Alireza-Sotoodeh/DeadReckoner/Report/Progress.md

## Software Architecture Evolution & Development Phases (ESP32-S3 N16R8)

The development of DeadReckoner followed a staged architecture-driven roadmap. Each phase established the technical foundation required for subsequent phases. The progression reflects the actual implementation history of the project, from early sensor evaluation to the current multi-core data-logging platform.

---

#### Phase 0: Legacy Prototype & Sensor Research [COMPLETED]

This phase focused on evaluating inertial navigation hardware and establishing the initial software baseline.

- [x] **Project Bootstrap:** Create the initial firmware framework and repository structure.
- [x] **MPU6500 Evaluation:** Integrate and validate the MPU6500 sensor library.
- [x] **DMP Integration:** Add and evaluate Digital Motion Processor (DMP) support.
- [x] **STM32/CubeIDE Development Environment:** Establish the initial embedded development workflow.
- [x] **Sensor Communication Validation:** Verify low-level IMU communication and register access.
- [x] **Linear Acceleration Processing:** Correct gravity-compensated acceleration calculations.
- [x] **OLED Interface Experiments:** Develop and validate the first display subsystem.
- [x] **Prototype Validation:** Confirm basic IMU acquisition and display functionality.

---

#### Phase 1: ESP32-S3 Migration & System Architecture [COMPLETED]

The project architecture was redesigned around the ESP32-S3 platform to provide additional processing power, memory resources, and real-time scheduling capabilities.

- [x] **Platform Migration:** Migrate the firmware from the ESP8266 NodeMCU platform to the ESP32-S3 N16R8.
- [x] **Firmware Reinitialization:** Rebuild the project structure around the new hardware platform.
- [x] **Pin Porting:** Remap all peripherals to the ESP32-S3 IO matrix.
- [x] **Hardware Redesign:** Update wiring architecture and peripheral connections.
- [x] **Firmware Flash Configuration:** Configure flashing and deployment parameters for ESP32-S3.
- [x] **System Bring-Up Verification:** Validate successful operation of all onboard peripherals.

---

#### Phase 2: RTOS & Multi-Core Framework [COMPLETED]

This phase transformed the firmware from a monolithic design into a real-time multi-core architecture.

- [x] **FreeRTOS Integration:** Introduce task-based scheduling.
- [x] **Dual-Core Architecture:** Separate acquisition and storage workloads across CPU cores.
- [x] **Sensor Task Implementation:** Execute high-frequency sensor acquisition on Core 0.
- [x] **Logging Task Implementation:** Execute storage operations on Core 1.
- [x] **Producer–Consumer Model:** Establish queue-based communication between tasks.
- [x] **Thread-Safe Data Exchange:** Replace shared-state communication with message passing.
- [x] **Race Condition Mitigation:** Eliminate direct inter-task memory contention.
- [x] **Real-Time Stability Validation:** Verify deterministic operation under sustained load.

---

#### Phase 3: Calibration & I2C Optimization [COMPLETED]

This phase focused on improving sensor accuracy, calibration persistence, and I2C bus reliability.

- [x] **I2C Fast Mode:** Increase bus speed to 400 kHz.
- [x] **EEPROM Calibration Storage:** Implement persistent storage for calibration data.
- [x] **Calibration Restoration:** Automatically restore bias values during startup.
- [x] **Calibration Compensation Fix:** Correct post-load sensor offset behavior.
- [x] **Bus Collision Prevention:** Suspend acquisition during EEPROM write operations.
- [x] **Dual-I2C Topology:** Move OLED traffic to the secondary I2C controller (`Wire1`).
- [x] **I2C Stability Validation:** Verify reliable operation of all I2C peripherals.

---

#### Phase 4: Hardware Validation & Performance Testing [COMPLETED]

This phase established confidence in hardware reliability and sensor performance through structured testing.

- [x] **MPU9250 Sanity Check:** Validate IMU initialization and communication.
- [x] **OLED Sanity Check:** Validate display communication and rendering.
- [x] **Hardware Integration Testing:** Verify complete system functionality.
- [x] **Static Drift Evaluation:** Measure long-term orientation stability.
- [x] **Dynamic Return-to-Zero Testing:** Evaluate accumulated drift after motion.
- [x] **Vibration Rejection Testing:** Assess filter robustness under vibration.
- [x] **Filter Validation:** Verify orientation estimation consistency.
- [x] **Performance Visualization Tools:** Develop drift-analysis visualization utilities.

---

#### Phase 5: SD Card Storage Architecture [COMPLETED]

This phase focused on selecting and validating a reliable storage subsystem for mission logging.

- [x] **SD Card Interface Investigation:** Evaluate multiple SD card connection strategies.
- [x] **SPI Storage Architecture:** Adopt SPI-based storage communication.
- [x] **Standalone SD Validation:** Create isolated SD card validation firmware.
- [x] **Hardware Adapter Evaluation:** Compare SD adapter implementations.
- [x] **Signal Integrity Optimization:** Operate entirely on the 3.3 V logic domain.
- [x] **SPI Frequency Optimization:** Limit SPI frequency to 10 MHz for stable operation.
- [x] **Storage Benchmarking:** Evaluate practical write performance.
- [x] **Final Storage Validation:** Successfully validate long-duration SD card operation.

---

#### Phase 6: Binary Logging Framework [COMPLETED]

The storage subsystem was expanded into a structured binary data-logging architecture.

- [x] **LogFrame Definition:** Design a fixed-size binary telemetry structure.

- [x] **Timestamp Integration:** Store acquisition timestamps for every sample.

- [x] **Quaternion Logging:** Record fused orientation estimates.

- [x] **Linear Acceleration Logging:** Record gravity-compensated acceleration vectors.

- [x] **Binary Block Writing:** Replace text-based logging with binary storage.

- [x] **Continuous SD Streaming:** Implement sustained high-rate data recording.

- [x] **Sequential Log File Naming:** Generate unique mission log files automatically.

- [x] **Boot-Time Log Discovery:** Scan storage and determine the next available log index.

- [x] **Mission File Management:** Track active and future log identifiers.

- [x] **Storage Capacity Monitoring:** Display available storage information to the user.

- [x] LogFrame Memory Optimization: Redesign the telemetry structure using a compact union-based memory layout.

- [x] PSRAM Logging Buffer: Implement high-capacity external PSRAM buffering for sustained logging operations.

- [x] Deterministic File Naming Scheme: Develop O(1) mission and recovery file generation logic.

- [x] Gap Frame Injection: Record SD-card disconnection events using dedicated marker frames.

- [x] Frame Counter Synchronization: Add thread-safe frame tracking across acquisition and logging tasks.

- [x] **LogFrame Memory Optimization:** Redesign the logging structure using packed memory layout and union-based payload sharing.

- [x] **64-bit Timestamp Support:** Replace overflow-prone timestamps with microsecond-resolution 64-bit hardware timestamps.

- [x] **Frame Sequence Tracking:** Add monotonic frame numbering for drop detection and recovery analysis.

- [x] **CRC-16 Per-Frame Integrity:** Add bit-by-bit CRC-16-IBM checksum to every `LogFrame` for silent corruption detection during offline analysis.

- [x] **Dropped Frame Accounting:** Monitor queue overflows and track lost samples during runtime.

- [x] **PSRAM Queue Architecture:** Introduce a large PSRAM-backed logging queue to decouple acquisition and storage workloads.

---

#### Phase 7: Fault Detection, Recovery & Mission Safety [COMPLETED]

A dedicated fault-management layer was added to increase system robustness during field operation.

- [x] **MPU9250 Disconnect Detection:** Detect unexpected sensor communication failures.

- [x] **Sensor Timeout Monitoring:** Monitor acquisition timing and communication health.

- [x] **Critical Fault State Machine:** Introduce centralized fault handling.

- [x] **Safe Logging Shutdown:** Protect recorded data during failures.

- [x] **Automatic File Synchronization:** Flush pending data before shutdown.

- [x] **Boot-Time SD Validation:** Verify storage availability during startup.

- [x] **OLED Fault Reporting:** Display diagnostic information to the operator.

- [x] **Audible Fault Alerts:** Add buzzer-based alarm notifications.

- [x] **Visual Fault Alerts:** Add LED-based warning indicators.

- [x] **Dynamic Recovery Protocol:** Attempt automatic recovery after sensor reconnection.

- [x] Runtime SD Card Recovery: Detect and recover from SD-card removal and reinsertion events during operation.

- [x] Recovery Fragment Logging: Create recovery log segments automatically after storage restoration.

- [x] Queue Integrity Protection: Eliminate stale queue data and cross-session frame contamination.

- [x] FAT Filesystem Performance Optimization: Prevent UI freezes caused by large directory traversal operations.

- [x] Storage Capacity Overflow Protection: Correct calculations for high-capacity SD cards (>32 GB).

- [x] Sensor Reconnection Stability Improvements: Remove queue-reset race conditions during MPU9250 recovery.

- [x] Safe Shutdown Protocol: Gracefully stop logging and synchronize pending data before power-off.

- [x] Watchdog-Safe Buffer Flushing: Prevent watchdog resets during large shutdown write operations.

- [x] **Mission Safety Mechanisms:** Prevent operation under unsafe sensor conditions.

- [x] **Runtime SD Card Recovery:** Automatically attempt SD-card reinitialization after storage failures.

- [x] **Recovery Log Fragment System:** Create recovery files automatically after successful SD reconnection.

- [x] **Logging Gap Markers:** Insert dedicated gap records into the binary stream after recovery events.

- [x] **MPU9250 Automatic Reinitialization:** Reconfigure the sensor and reload calibration after reconnection.

- [x] **Write Verification Layer:** Validate every SD write operation and detect silent storage failures.

- [x] **Recovery State Isolation:** Prevent corrupted file handles from resuming normal logging.

- [x] **Safe Power-Off Procedure:** Flush queued telemetry and synchronize storage before shutdown.

- [x] **Watchdog-Safe Queue Draining:** Prevent resets while flushing large buffered datasets.

---

#### Phase 8: User Interface & Operational Monitoring [COMPLETED]

This phase improved usability and runtime observability.

- [x] **Multi-Page OLED Interface:** Develop operational display screens.

- [x] **Runtime Status Visualization:** Present sensor and system status information.

- [x] **Storage Monitoring Interface:** Display SD card statistics and capacity information.

- [x] **Display Mode Selection:** Implement selectable display modes.

- [x] **Buzzer Control Interface:** Add runtime buzzer enable/disable functionality.

- [x] **SD Card Management Menu:** Add dedicated storage-management screens.

- [x] **System Diagnostics Display:** Present fault and recovery information.

- [x] Recording Time Visualization: Replace raw frame counters with mission elapsed time display.

- [x] OLED Power Management: Implement automatic display sleep and wake-up functionality.

- [x] Runtime Recovery Feedback: Present SD-card recovery and fault status information to the user.

- [x] **Hierarchical Menu System:** Implement multi-level OLED menu navigation.

- [x] **SD Card Information Dashboard:** Display storage capacity, free space, remaining recording time, file count, and frame-drop statistics.

- [x] **Runtime Log Management:** Allow creation of new mission log files directly from the device UI.

- [x] **Log Cleanup Utility:** Add on-device deletion and formatting workflow for recorded logs.

- [x] **OLED Power Management:** Implement automatic display sleep and wake-up behavior.

- [x] **Display Mode Configuration:** Support always-on and auto-off display modes.

- [x] **Runtime Audio Configuration:** Allow enabling and disabling audible notifications.

- [x] **Waypoint Tagging Interface:** Add dedicated user event markers with visual and audible feedback.

- [x] **Recovery Status Visualization:** Display real-time recovery progress and fault diagnostics.

---

#### Phase 8.5: Memory Optimization & Scalability [COMPLETED]

This phase focused on improving memory efficiency, scalability, and long-duration mission support.

- [x] Union-Based Telemetry Architecture: Share memory between future sensor payload types.
- [x] Packed Binary Structures: Reduce memory footprint and storage bandwidth requirements.
- [x] PSRAM Buffer Integration: Utilize external PSRAM for large-scale telemetry buffering.
- [x] Concurrent Data Protection: Introduce synchronization mechanisms for shared counters and event tagging.
- [x] Scalable Logging Foundation: Prepare the logging framework for optional GPS extension (outdoor calibration only).

---

#### Phase 9: Data Analysis & Validation Toolchain [COMPLETED]

Tools were developed to analyze recorded datasets and verify system performance.

- [x] **MATLAB Binary Reader:** Develop an offline decoder for recorded log files.

- [x] **Quaternion Visualization:** Plot recorded orientation data.

- [x] **Acceleration Visualization:** Analyze recorded acceleration signals.

- [x] **Drift Analysis Workflow:** Evaluate long-term navigation stability.

- [x] **Performance Validation Pipeline:** Create a repeatable testing methodology.

- [x] **Experimental Result Verification:** Correlate recorded data with physical tests.

- [x] Binary Fragment Reconstruction: Automatically stitch fragmented recovery logs into continuous datasets.

- [x] Garbage Frame Filtering: Remove corrupted trailing frames generated by interrupted writes.

- [x] Quaternion-to-Euler Conversion: Add orientation visualization in roll, pitch, and yaw form.

- [x] Statistical Signal Analysis: Calculate RMS, mean, peak, and noise metrics from recorded data.

---

#### Phase 10: Offline PDR Pipeline & Verification [COMPLETED]

The Python-based Pedestrian Dead Reckoning pipeline was implemented in `compare_paths.py` and verified against ground-truth GPS (Garmin eTrex 30x + Geo Tracker Android app). GPS serves only as an external ground-truth reference for offline accuracy validation — it is **not** part of the core dead-reckoning system.

- [x] **GPS Fields Reserved in LogFrame:** Prepare the logging structure for auxiliary GNSS data (outdoor calibration extension only).
- [x] **GPS Payload Reservation:** Reserve binary payload space for auxiliary GNSS records through a shared LogFrame union architecture.
- [x] **Future-Proof Log Structure:** Design the logging format to support mixed IMU and GPS event packets without breaking compatibility.
- [x] **Binary Parser & Verification:** Parse 45-byte/47-byte BIN files, validate CRC-16, extract timestamps + quaternions + acceleration.
- [x] **World-Frame Acceleration Rotation:** Transform body-frame acceleration using stored quaternions (for step detection analysis).
- [x] **Step Detection:** Peak-finding on acceleration magnitude for footstep identification (Weinberg empirical formula).
- [x] **Step Length Estimation:** Weinberg empirical formula for per-step distance.
- [x] **Heading from Quaternions:** Extract magnetometer-stabilized yaw for each step from firmware Madgwick quaternions.
- [x] **GPX Parsing:** Parse both Garmin and Geo Tracker GPX formats for ground-truth comparison.
- [x] **Brute-Force Heading Alignment:** Search 0–360° (0.5° steps) for optimal heading offset between PDR and GPS paths.
- [x] **PDR Accuracy Metrics:** Compute path length, GPS distance, and error percentage per segment.
- [x] **Trajectory Visualization:** 2D path plots with matplotlib, per-segment and summary overlay plots.
- [ ] **ZUPT + RTS Smoother:** Bidirectional batch optimization over entire walk for minimal drift (planned enhancement).
- [x] **`--gps-guided` mode:** Substitutes GPS heading for PDR heading to prove step length accuracy (shape 156m → 3m).
- [x] **Path shape diagnosis:** Madgwick filter magnetometer yaw lock → Mahony filter fix.

**Verification Results:** 5 walk segments tested, avg error **4.9%** (best 4.0%, worst 7.8%, total 2.8%) after tune_pdr.py bug fix and K=0.425 calibration. IMU-only PDR is sufficient — GPS and BMP280 are not required for dead reckoning. GPS is used exclusively as external ground truth for accuracy validation, not as a navigation input.

---

#### Phase 11: GPS Module Validation — Outdoor Calibration Extension [COMPLETED]

Hardware diagnostic and validation tool set for the GY-GPS6Mv2 (NEO-6M) GPS module on Arduino Uno. This module is an **optional extension** for outdoor MPU9250 and filter calibration testing — not a core component of the indoor PDR system. Three sketches developed and tested at `Test- Sanity Check/GY-GPS6Mv2/`.

- [x] **GY-GPS6Mv2.ino — Live Diagnostic Monitor:** Real-time display of fix quality (2D/3D), satellite count, HDOP, position, altitude, speed, UTC time. Includes: time-to-first-fix measurement, 10-second heartbeat when no fix, 5-minute summary statistics (min/avg/max HDOP and satellites, fix uptime %). Non-blocking error detection — prints wiring error once then continues reading. All `F()` macros for Uno SRAM.
  *Results: cold start TTFF 778 s (indoor at 3.3V under roof — worst case). Hot start 4 s. HDOP 18–81, satellites avg 6.9, fix uptime 60–95%.*
- [x] **GPS_ColdStart.ino — Start Timing & Fix Reliability:** Three-phase test: (1) Cold start TTFF measurement from power-on to first 3D fix. (2) 2-minute stabilisation log at 1 Hz with lat/lon/alt/HDOP/sats. (3) Re-acquisition test (user power-cycles GPS) with separate TTFF. Prints final summary with position scatter (lat/lon σ in metres), HDOP/satellite stats, uptime %.
  *Results: hot start 4 s (BBR cached from prior run), 100% fix uptime over 2 min, position scatter ±1.84 m lat / ±2.96 m lon, altitude 1741.2 m (matches city reference ±6.5 m range), HDOP 16–24 indoors at 3.3V. Tests performed indoors under roof at 3.3V — harsh conditions confirm module functional. Expected outdoor performance: cold start 30–60 s, HDOP 1.0–2.5, position σ ±1 m.*
- [x] **GPS_StaticPrecision.ino — 1-Hour Static Precision:** Logs at 1 Hz for 3600 s. Reports lat/lon position scatter in metres (σ), altitude min/max/mean/σ, HDOP and satellite statistics, fix uptime %, and CEP (Circular Error Probable). Uses offset-from-reference technique for float precision. CSV output for external post-processing.
  *Status: sketch created, tested indoors briefly — pending full 1-hour outdoor run.*

---

#### Phase 12.5: PDR vs GPS Verification [COMPLETED]

Offline comparison tool that validates the PDR pipeline against ground-truth GPS tracks.

- [x] **compare_paths.py:** Full PDR pipeline: binary parser, Weinberg step detection, quaternion yaw heading, GPX parser (Garmin + Geo Tracker), brute-force heading alignment, per-segment metrics.
- [x] **Analysis Output:** Summary table with error % per segment; overlay plots saved to `analysis/` directory.
- [x] **Interactive Mode:** Slider-based tuning of heading offset and Kalman smoothing gain.

---

#### Phase 13: Extension — WiFi GPS Anchoring for Outdoor Calibration [COMPLETED]

Phone-based GPS start/end anchoring via ESP32 WiFi soft-AP and captive portal. Enables absolute position reference for each log file during **outdoor calibration walks only**. This is an auxiliary extension — the core system is indoor PDR without GPS.

- [x] **WiFi AP + DNS Captive Portal:** ESP32 creates "DeadReckoner-S3" AP with password "deadreckoner". DNS redirects browsing phones to embedded HTML form.
- [x] **Phone GPS Data Entry:** Browser-based form with lat, lon, alt (optional), and date/time fields. JavaScript parses local time to Unix epoch, sends JSON via POST to `/gps`.
- [x] **GPS Frames (0xBB/0xCC):** `writeGPSFrame()` stores lat (double), lon (double), alt (float), epoch (uint32_t) in LogFrame GPS union. 0xBB = start anchor, 0xCC = end anchor.
- [x] **State Machine Integration:** GPS prompts (PROMPT_START, PROMPT_END, WAITING with SSID+IP display, CONFIRM_EXIT) integrated into UI state machine.
- [x] **Trigger Points:** GPS prompt at boot (one-shot), Create New File, Format (each file gets its own anchor). Shutdown prompts for end GPS.
- [x] **Deferred File Creation:** When GPS start is pending, file creation is deferred until pairing completes (so 0xBB is the first frame after header).
- [x] **SdFat/FS.h Conflict Resolved:** `#define File SdFat_File_` macro rename before WebServer include prevents C++ name collision with ESP32 FS.h.
- [x] **OLED Sleep Prevention:** Auto-sleep skipped during GPS WAITING, PROMPT_START, PROMPT_END, CONFIRM_EXIT states.
- [x] **GPS Bug Fixes:** JSON string-vs-number fix (`parseFloat()` in JS), `writeGPSFrame()` now correctly stores alt and epoch, time field changed from UTC readonly to editable local time.
- [ ] **UART NEO-6M GPS Module:** Direct GPS module integration (without phone) for outdoor calibration walks — pending extension.

---

#### Phase 15: PDR Refinement & Path Shape Fix [COMPLETED]

Refined the Python analysis pipeline and diagnosed/fixed the path shape mismatch. GPS data (from outdoor calibration walks) served as external ground-truth reference only.

- [x] **`tune_pdr.py` bug fixed:** `compute_gps_distance` was receiving local xy (meters) instead of lat/lon (degrees), causing 100% error for all K values.
- [x] **Optimal Weinberg K found:** K=0.425, height=1.5, dist=25 — avg error 4.9%, total 2.8%.
- [x] **`compare_paths.py` rewritten:** Correct 47-byte BIN parser (magic 0xDEADC0DE, CRC-16 matching firmware), 2D heading+drift optimization, path shape metrics (Hausdorff + avg dist), per-segment path maps.
- [x] **CRC-16 verified:** 0% failure across all ~568K frames (matched firmware's poly 0xA001, init 0xFFFF, no final XOR).
- [x] **FileHeader duplication fixed:** Frame reading now starts at offset 16 (after FileHeader).
- [x] **`--gps-guided` mode:** Proves PDR step lengths are correct — avg shape 3m vs GPS when using correct heading.
- [x] **Path shape root cause diagnosed:** Madgwick filter incorporates magnetometer into gradient descent at full `beta` strength, locking yaw to magnetic North. `zeta=0` already (unrelated).
- [x] **Firmware fix applied:** `ESP32_S3.ino:114` changed `MADGWICK → MAHONY`.
- [ ] **Re-collect walks:** Re-run 5 segments with Mahony filter and verify shape improvement.

---

#### Phase 14: GPX Fusion Tool (Python/PyQt6) [COMPLETED]

A PyQt6 desktop application at `Code_deadreckoner/Python/GPXFusion/fusion_ui.py` that fuses GPS logs from Garmin eTrex 30x and Geo Tracker Android app into a single accurate path using a Kalman filter with RTS smoothing.

- [x] **GPX Parser:** Parse standard GPX + Geo Tracker `geotracker:meta` extensions (accuracy `c`, speed `s`). Source detection by filename substring.
- [x] **Kalman Filter Engine:** Constant-velocity motion model in local meters (equirectangular projection). Per-device noise: Geo Tracker uses reported `c` field, Garmin defaults to 6 m.
- [x] **RTS Backward Smoother:** Bidirectional Rauch–Tung–Striebel pass over entire fused sequence.
- [x] **Time Grid Interpolation:** Resample all device tracks to a common 1 Hz grid.
- [x] **Offline Map (matplotlib):** Static map with lat/lon grid, color-coded raw tracks, bold red fused path, start/end markers, stats overlay box. No internet required.
- [x] **Online Map (folium):** Interactive Leaflet map with 5 tile providers (OpenStreetMap, CartoDB positron, CartoDB dark_matter, Esri WorldImagery, Esri WorldTopoMap).
- [x] **Map Mode Switching:** QComboBox toggles between offline and online. Online grayed out if folium/PyQt6-WebEngine missing.
- [x] **Tile Provider Selection:** QComboBox triggers map regeneration on change.
- [x] **Proxy Settings:** ProxyDialog (QDialog) with enable checkbox, host QLineEdit, port QSpinBox. Applied to connectivity check and folium tile fetching.
- [x] **Connectivity Check:** `urllib` HEAD request to jsdelivr CDN before loading folium map.
- [x] **Walk Group Management:** Tabs for organizing walks. "+ Add Walk" / "− Remove" buttons.
- [x] **GPX File Import:** QFileDialog + drag-and-drop support. File info panel on selection.
- [x] **Fuse Button:** Green-styled QPushButton. Runs Kalman fusion on all files in the current tab.
- [x] **Export Fused GPX:** Save fused result as standard GPX via QFileDialog.
- [x] **Stats Panel:** Shows fused path: points, distance (km), duration (min), avg speed (m/s).
- [x] **Control Panel:** Process Noise, Geo Tracker Noise, Garmin Noise spinboxes + RTS Smoother checkbox.
- [x] **Refresh Map Button:** Regenerates current map mode.
- [x] **Matplotlib Zoom Buttons:** Zoom In (+), Zoom Out (−), Reset (R) — adjusts plot margin factor.
- [x] **Resize Handling:** `resizeEvent` re-scales pixmap in offline mode; calls `map.invalidateSize()` for online folium map.
- [x] **QWebEngineView Unparent Fix:** `setParent(None)` before `setHtml()` makes `loadFinished` fire for CDN-script pages. Reparent with CSS viewport fix on load.
- [x] **Compositor null texture fix:** Preserve web view size via `resize(size)` before unparenting.
- [x] **Stylesheet Fixes:** `.QWidget` selector to avoid subclass interference. QPushButton `:pressed` state. QComboBox styling. QSpinBox up/down button sub-controls. QStackedWidget background.
- [x] **Stats panel fixed height:** `setFixedHeight(64)` prevents layout shift after fusion.

---
