Alireza-Sotoodeh/DeadReckoner/Code_deadreckoner/Matlab/3-BinReader/Mission_001_Report.txt

=========================================
   MISSION DIAGNOSTIC REPORT
=========================================
Mission ID        : Mission_001
Fragments Merged  : 2
Total Frames      : 798
Mission Duration  : 21256901.94 Seconds
-----------------------------------------
HARDWARE INTEGRITY
Silent Drops      : 5759448464580 Frames
SD Recovery Gaps  : 74 Events
User Tags         : 20 Waypoints
-----------------------------------------
THERMAL & SENSOR DATA
Max Temperature   : 115031755391752648790712230019596288.00 °C
Min Temperature   : -3904719107783660517899615323631386624.00 °C
=========================================
