Alireza-Sotoodeh/DeadReckoner/Code_deadreckoner/Matlab/3-BinReader/Mission_001_Plot.png

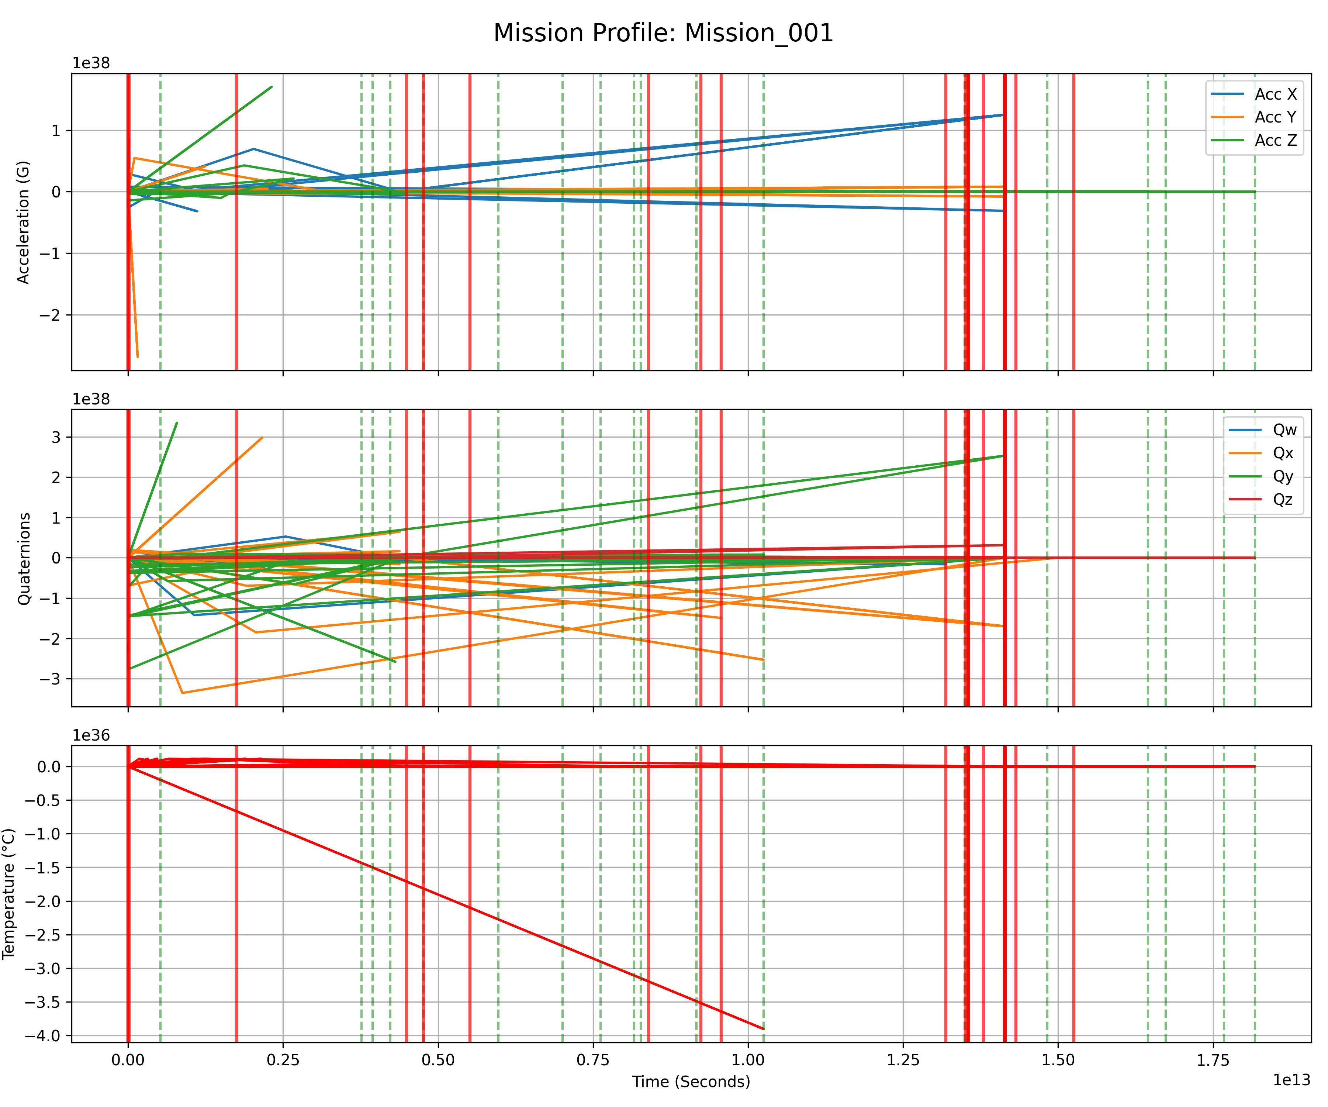
Code_deadreckoner/Matlab/3-BinReader/Mission_001_Plot.png
