Alireza-Sotoodeh/DeadReckoner/Collectd Data/2026-20-6-6AM/analysis/all_segments_overlay.png

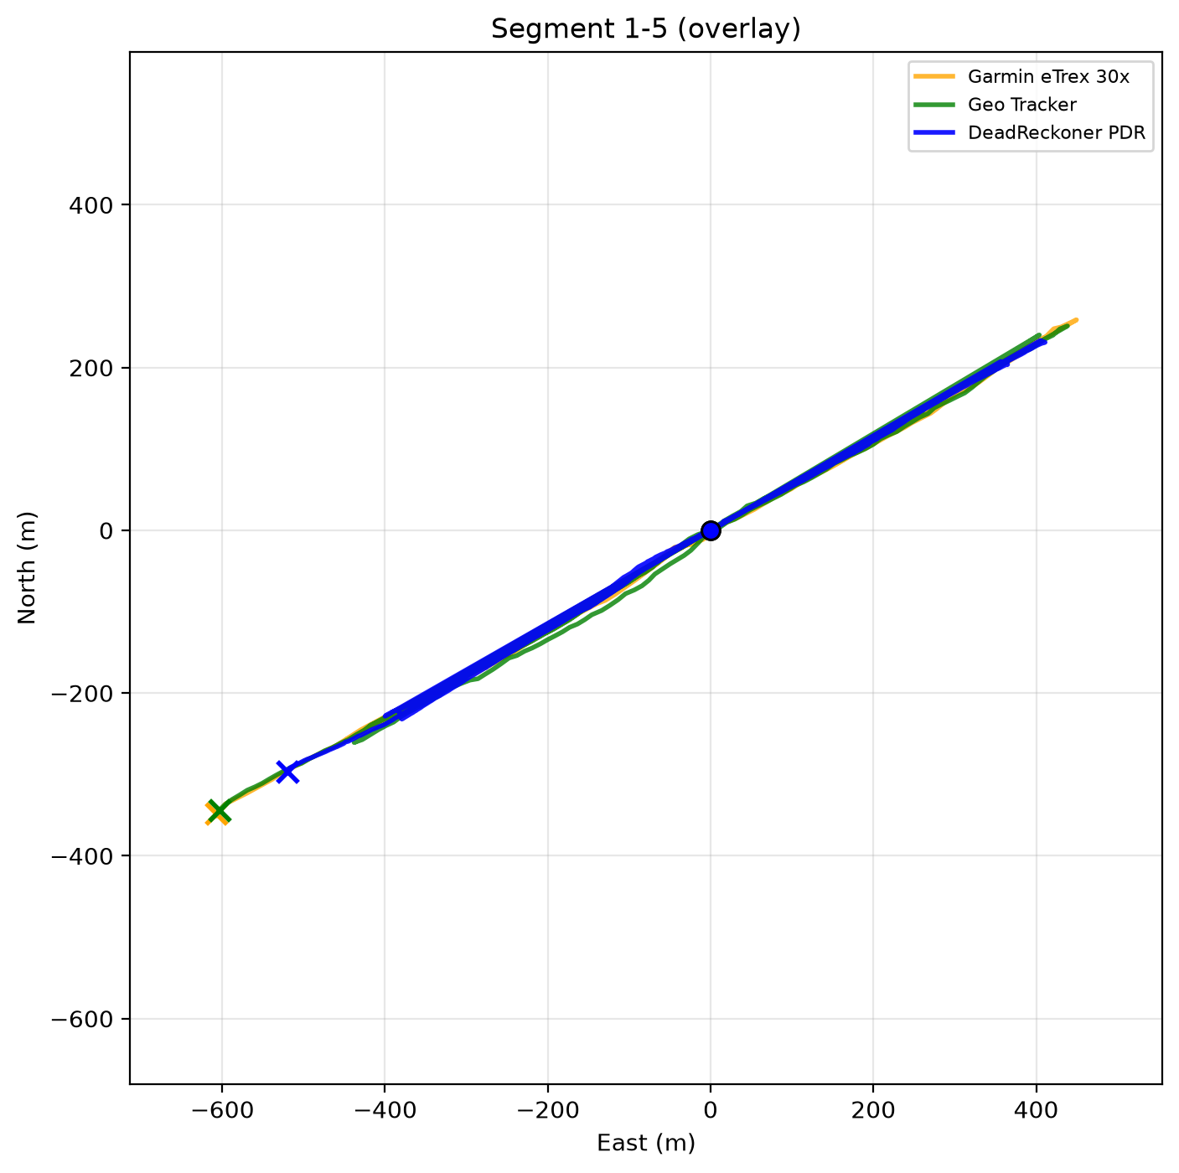
Collectd Data/2026-20-6-6AM/analysis/all_segments_overlay.png
