Alireza-Sotoodeh/DeadReckoner/Collectd Data/2026-20-6-6AM/analysis/summary_comparison.png

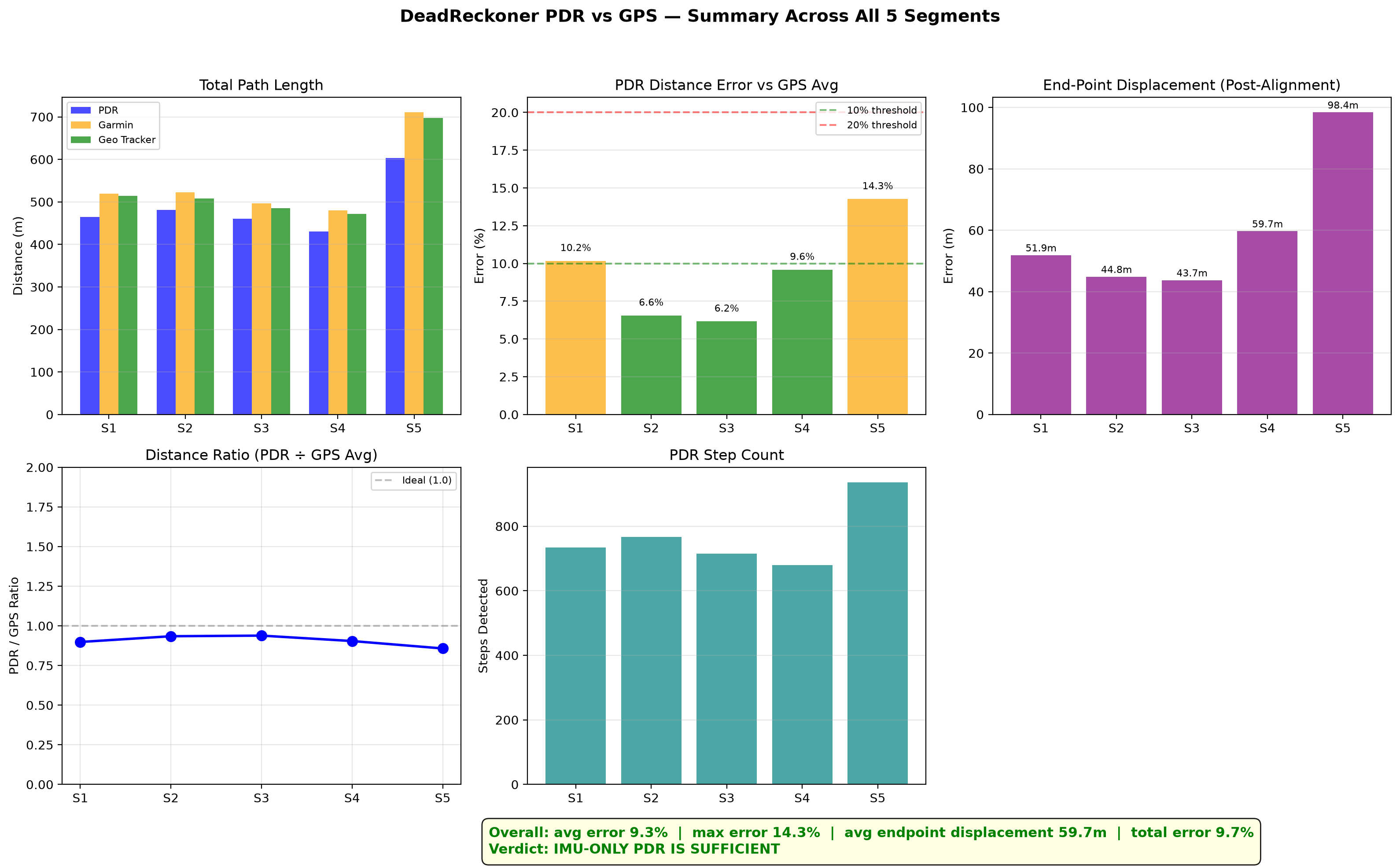
Collectd Data/2026-20-6-6AM/analysis/summary_comparison.png
