Alireza-Sotoodeh/DeadReckoner/Collectd Data/2026-21-6-6AM/analysis/1/accel_diagnostic.png

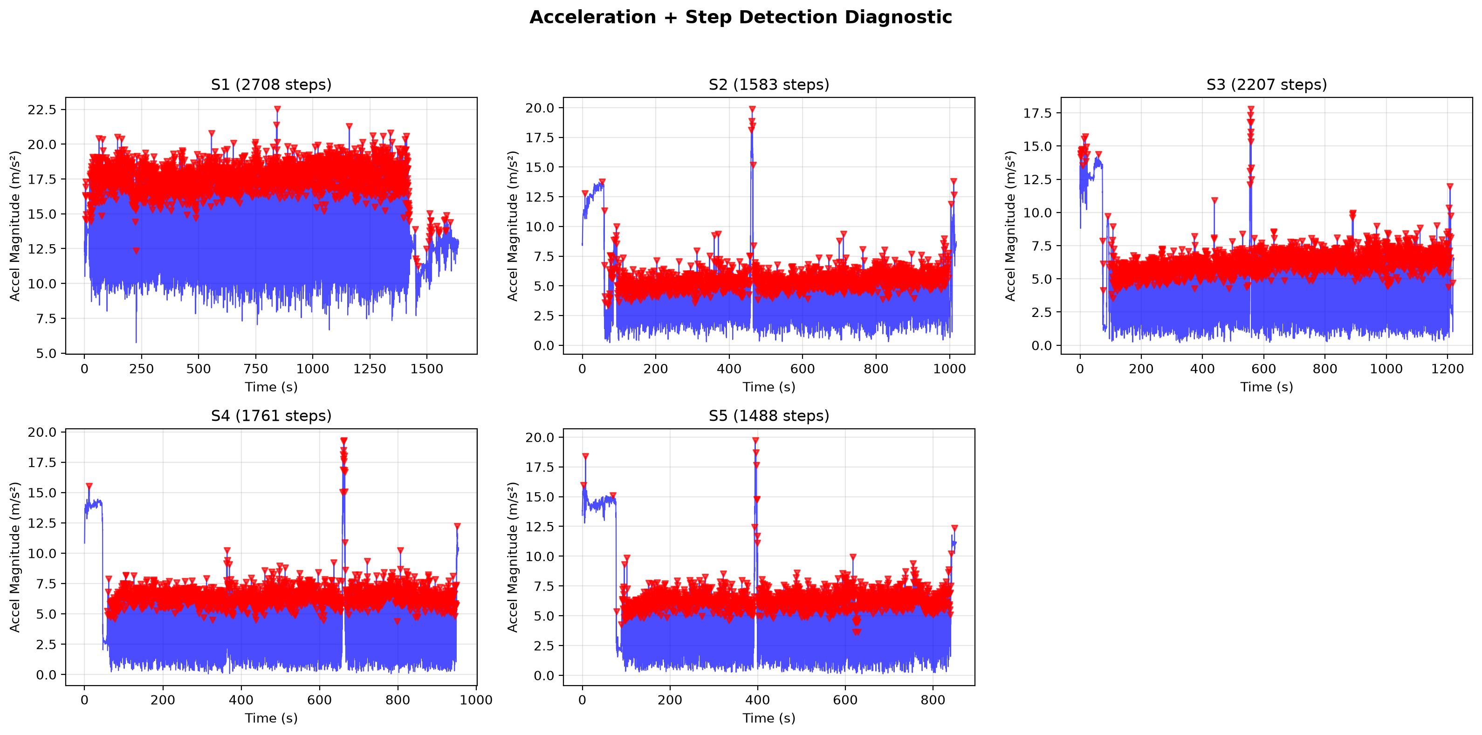
Collectd Data/2026-21-6-6AM/analysis/1/accel_diagnostic.png
