Alireza-Sotoodeh/DeadReckoner/Collectd Data/2026-21-6-6AM/analysis/1/heading_drift.png

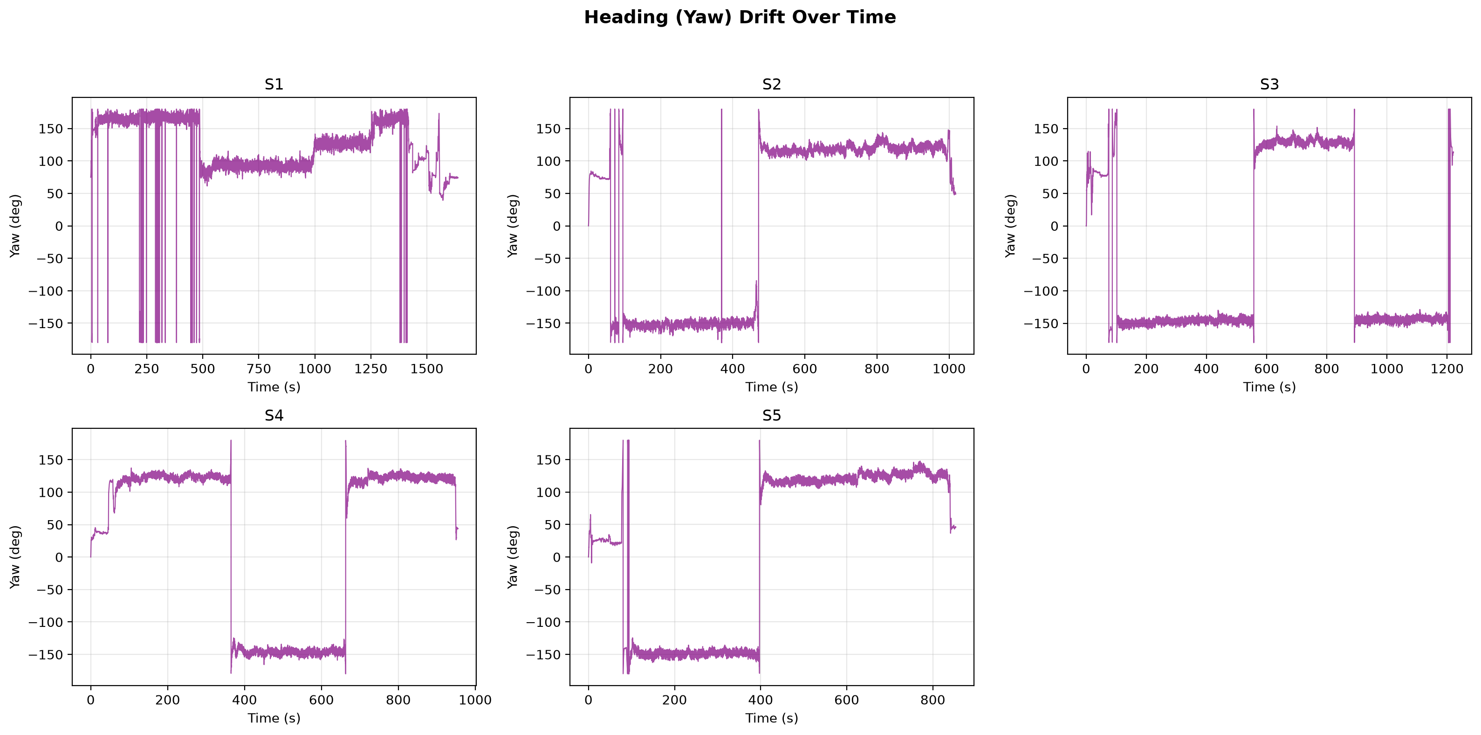
Collectd Data/2026-21-6-6AM/analysis/1/heading_drift.png
