Alireza-Sotoodeh/DeadReckoner/Collectd Data/2026-21-6-6AM/analysis/1/summary_comparison.png

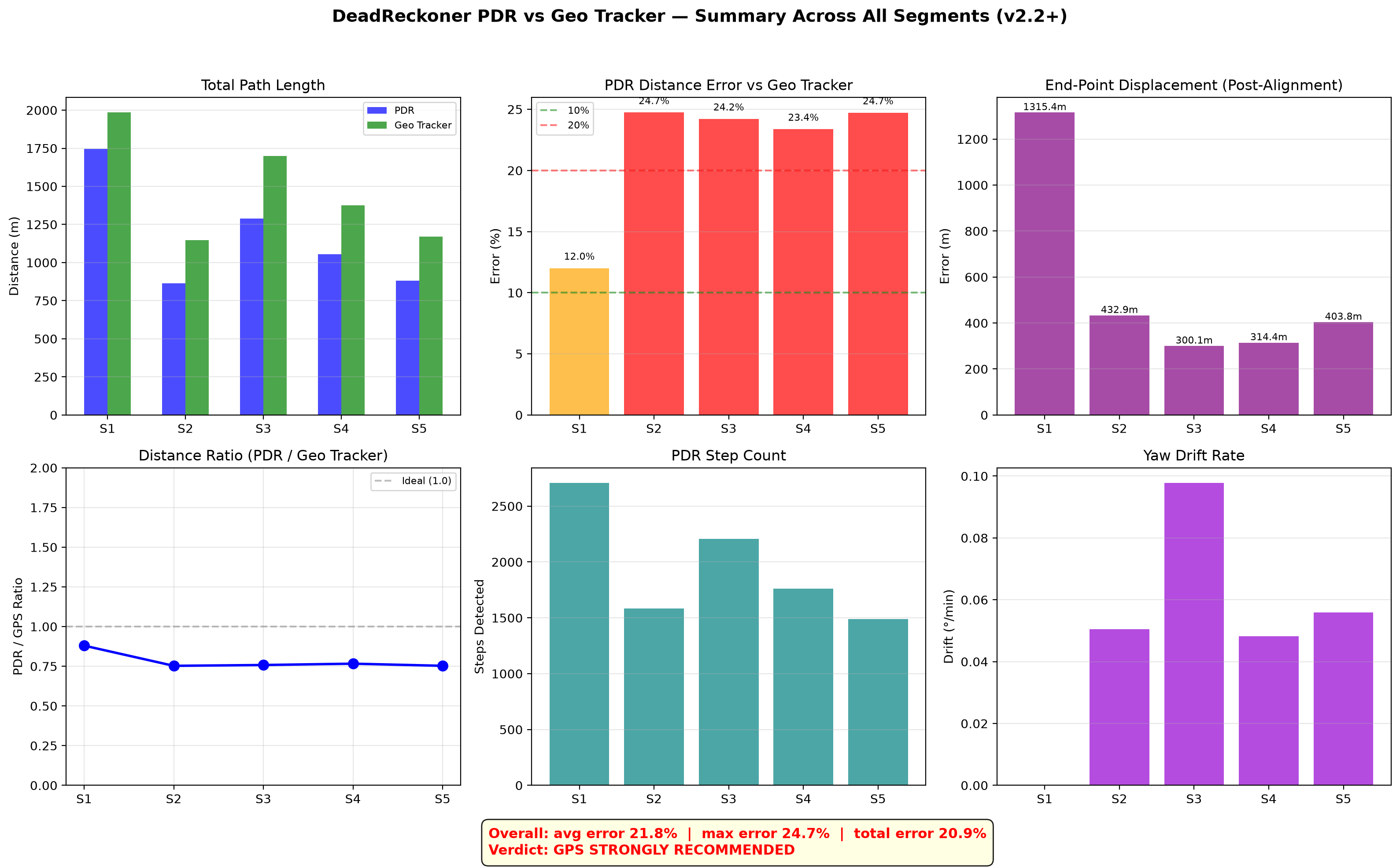
Collectd Data/2026-21-6-6AM/analysis/1/summary_comparison.png
