Alireza-Sotoodeh/DeadReckoner/Collectd Data/2026-21-6-6AM/analysis/4/heading_comparison.png

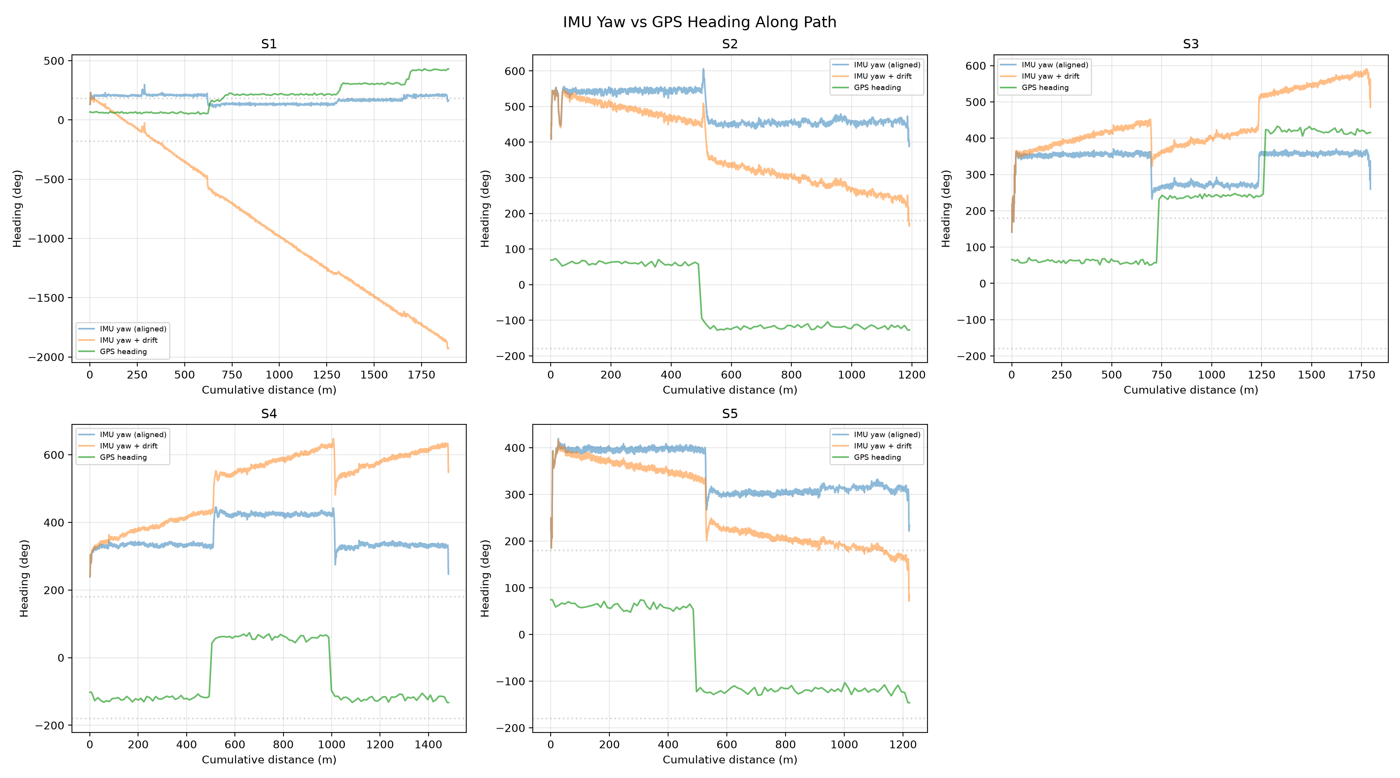
Collectd Data/2026-21-6-6AM/analysis/4/heading_comparison.png
