Alireza-Sotoodeh/DeadReckoner/Collectd Data/2026-21-6-6AM/analysis/4/path_s4.png

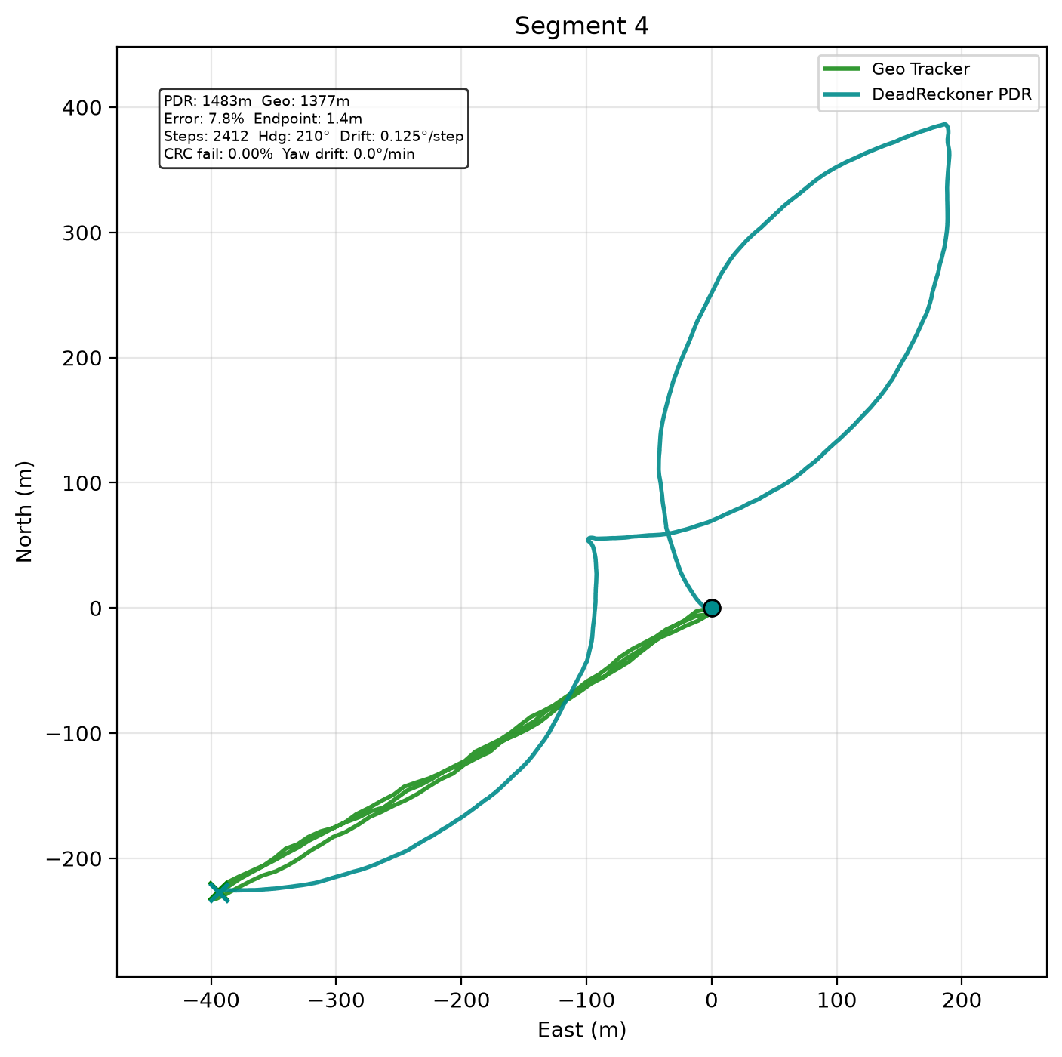
Collectd Data/2026-21-6-6AM/analysis/4/path_s4.png
