Alireza-Sotoodeh/DeadReckoner/Diagram_deadreckoner/Li-ion-battery-discharge-voltage-curve.png

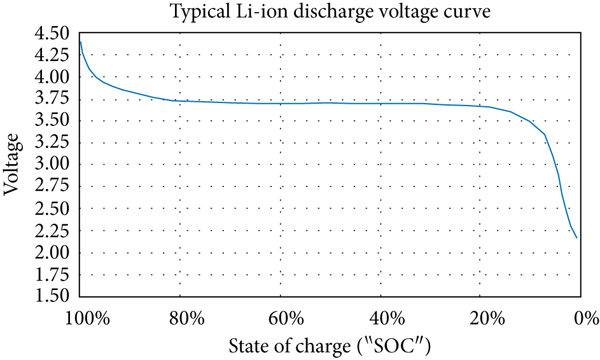
Diagram_deadreckoner/Li-ion-battery-discharge-voltage-curve.png
