Alireza-Sotoodeh/DeadReckoner/Diagram_deadreckoner/Lipo_VS_LIIon.png

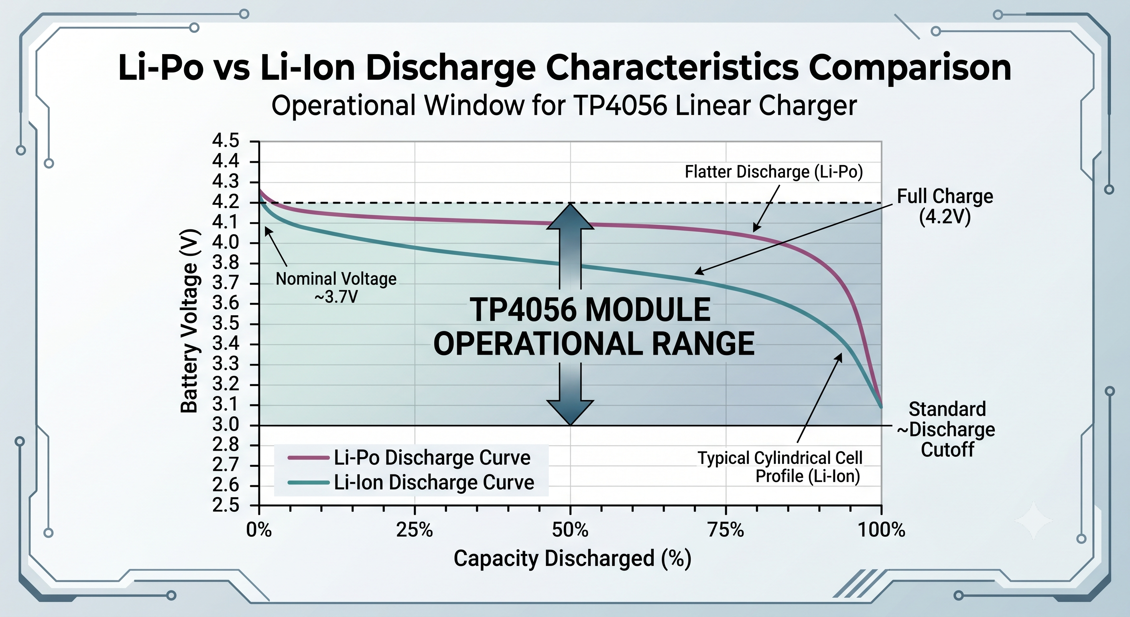
Diagram_deadreckoner/Lipo_VS_LIIon.png
