Alireza-Sotoodeh/DeadReckoner/Diagram_deadreckoner/pinsNodeMUC8266.jpg

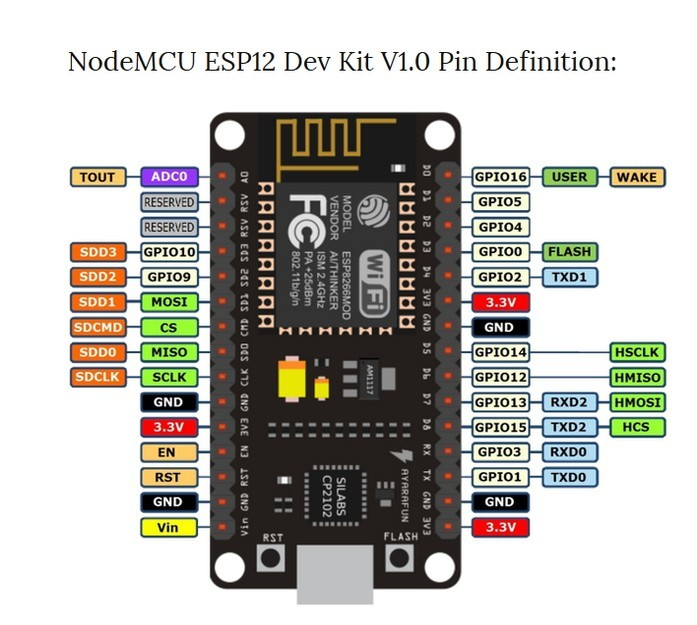
Diagram_deadreckoner/pinsNodeMUC8266.jpg
