Alireza-Sotoodeh/DeadReckoner/Diagram_deadreckoner/SD card adaptors-1.png

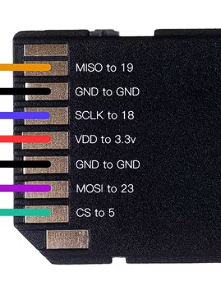
Diagram_deadreckoner/SD card adaptors-1.png
