Alireza-Sotoodeh/DeadReckoner/Diagram_deadreckoner/SD card adaptors-3.jpg

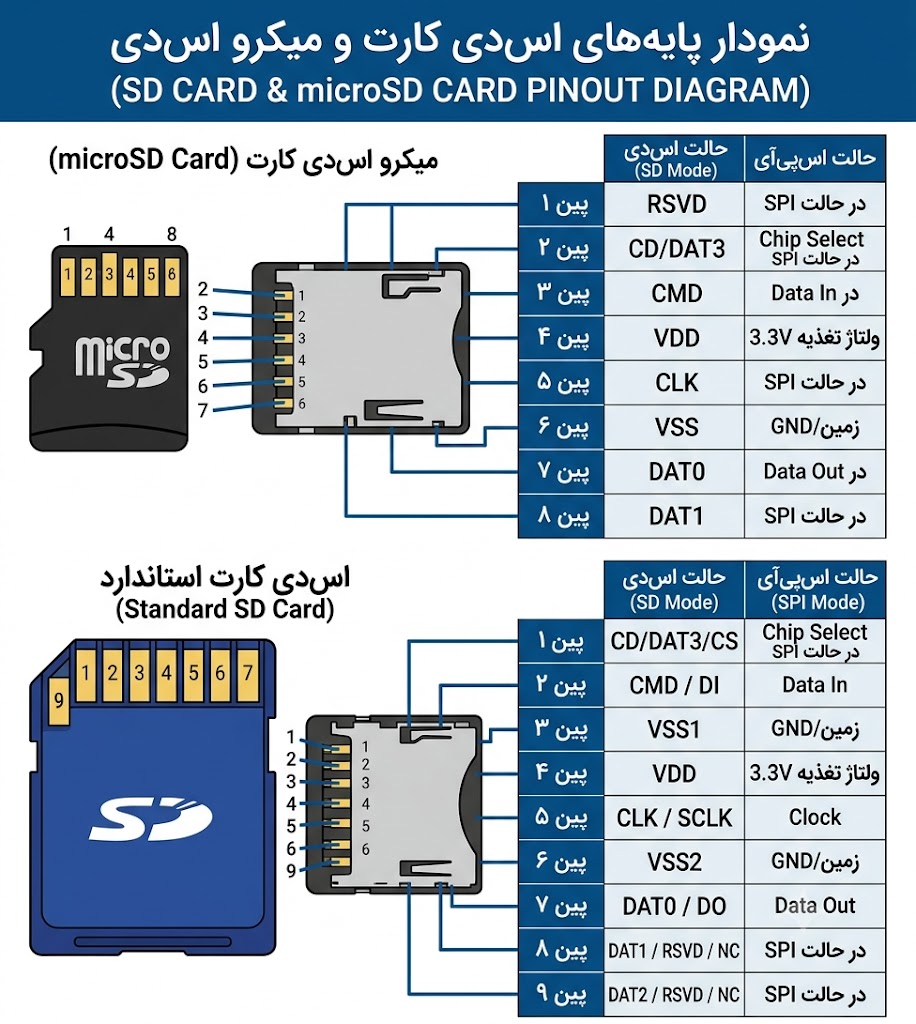
Diagram_deadreckoner/SD card adaptors-3.jpg
