Alireza-Sotoodeh/DeadReckoner/Diagram_deadreckoner/SD card adaptors-4.png

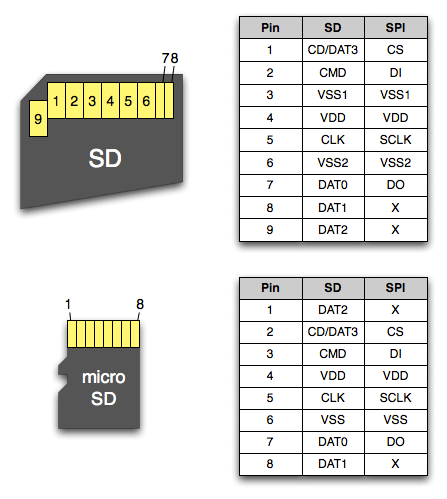
Diagram_deadreckoner/SD card adaptors-4.png
