Alireza-Sotoodeh/DeadReckoner/Code_deadreckoner/Matlab/3-BinReader/Tests/5-test recovery with PSRAM-make mistake/2.png

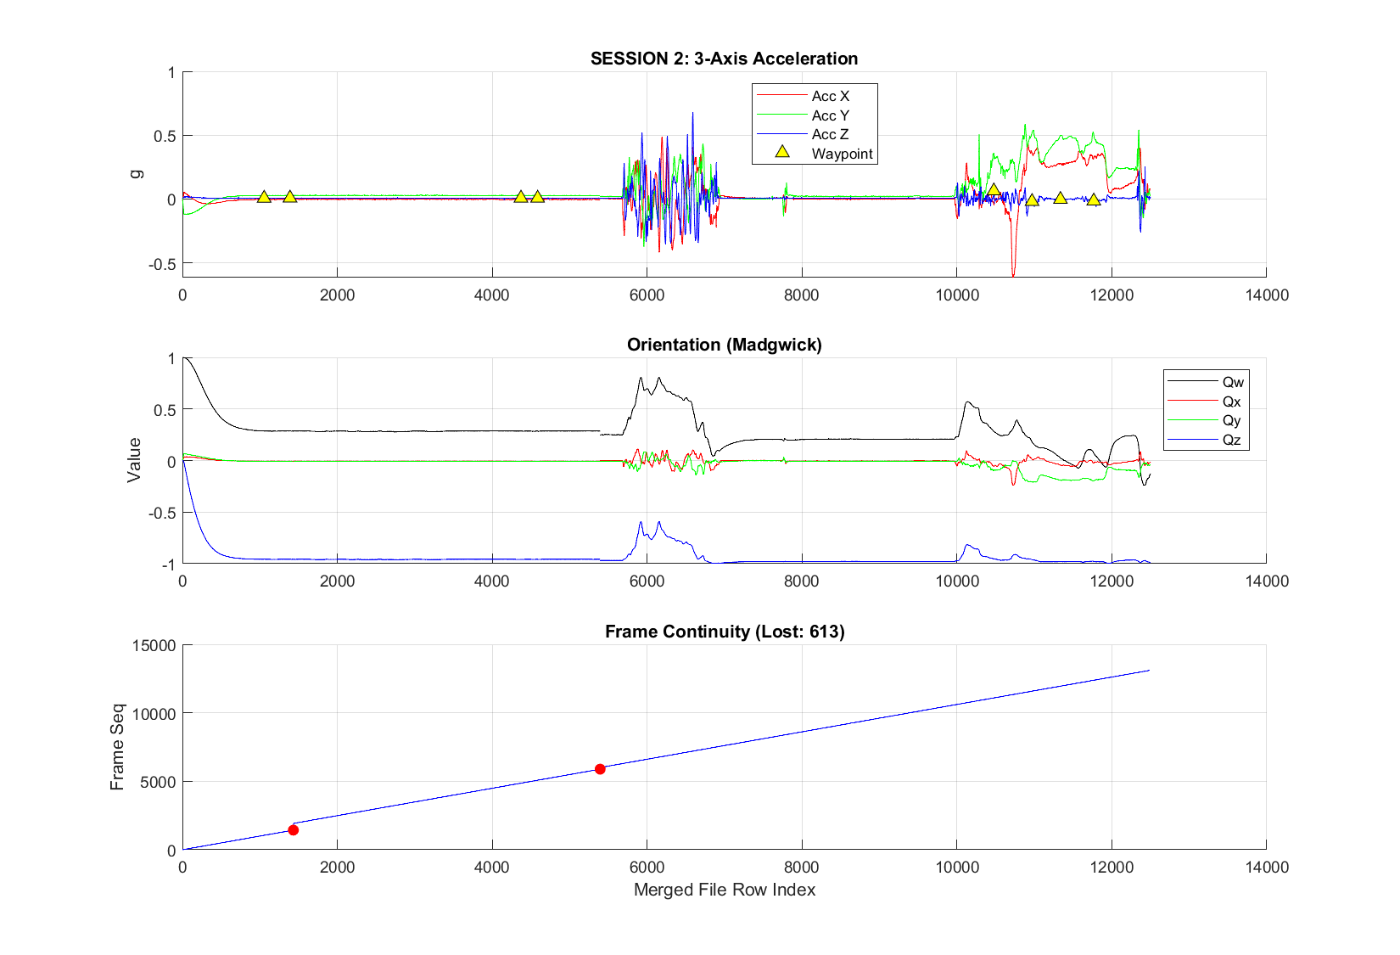
Code_deadreckoner/Matlab/3-BinReader/Tests/5-test recovery with PSRAM-make mistake/2.png
