Alireza-Sotoodeh/DeadReckoner/Collectd Data/2026-21-6-6AM/analysis/5-fix/gps_guided_s1.png

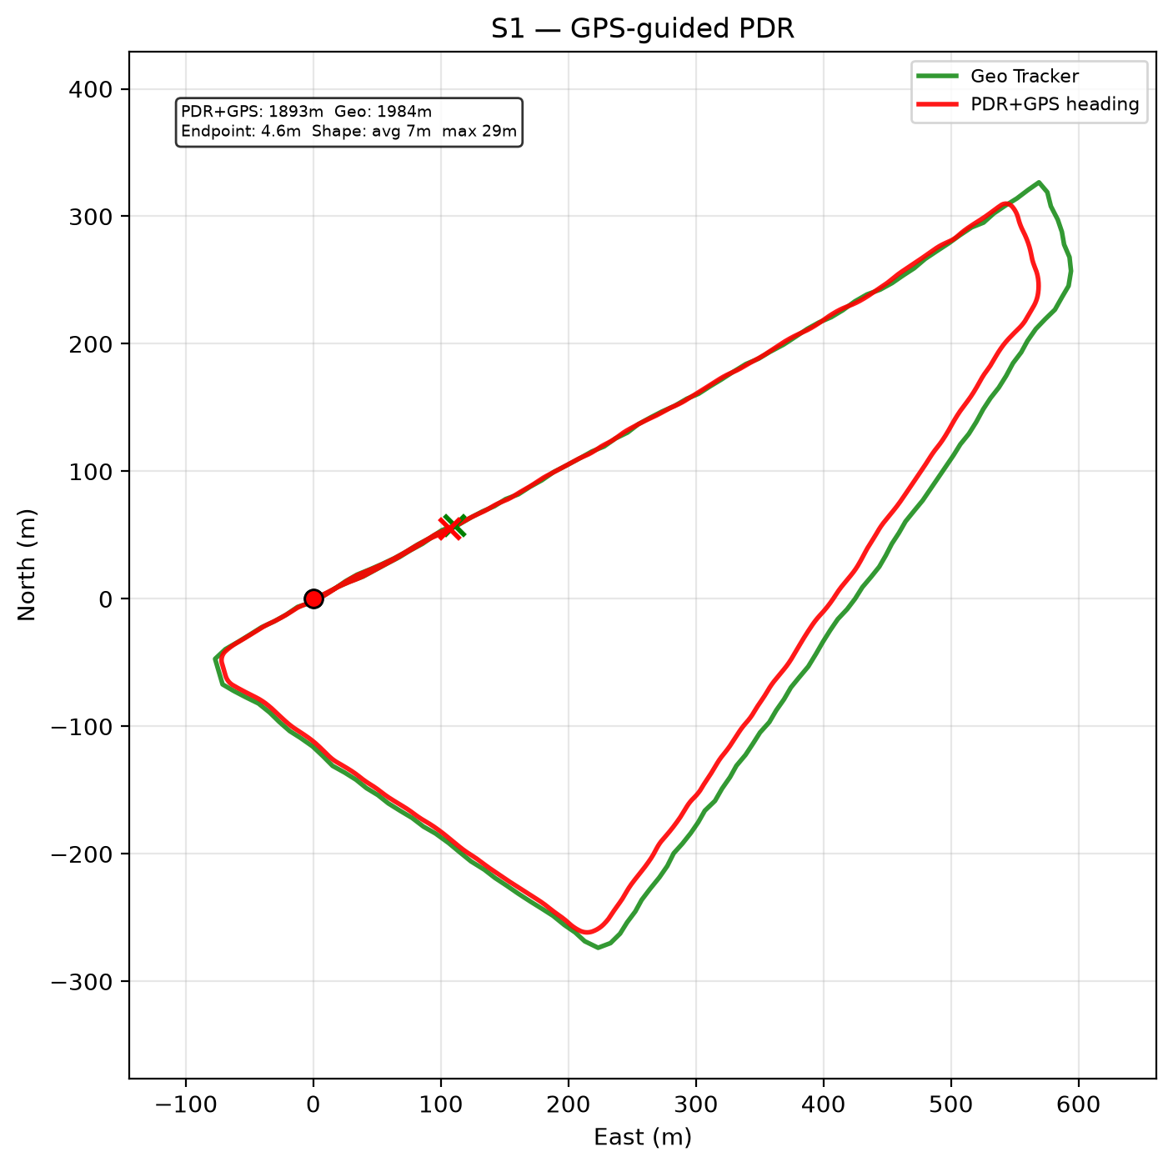
Collectd Data/2026-21-6-6AM/analysis/5-fix/gps_guided_s1.png
