Alireza-Sotoodeh/DeadReckoner/Test- Sanity Check/MPU9250/Result Test_MPU9250.txt

=================================
Starting MPU9250 Health Check...
=================================
WHO_AM_I Register Value: 0x71
STATUS: MPU9250 is ONLINE and HEALTHY.
Sensor awakened. Reading raw data...
Raw Accel -> X: -328 | Y: -20 | Z: 16208
Raw Accel -> X: -276 | Y: -24 | Z: 16372
Raw Accel -> X: -260 | Y: -44 | Z: 16508
Raw Accel -> X: -260 | Y: 32 | Z: 16348
Raw Accel -> X: -316 | Y: 12 | Z: 16668
Raw Accel -> X: -284 | Y: 20 | Z: 16632
Raw Accel -> X: -304 | Y: 40 | Z: 16524
Raw Accel -> X: -224 | Y: -52 | Z: 16660
Raw Accel -> X: -288 | Y: 0 | Z: 16588
Raw Accel -> X: -296 | Y: 80 | Z: 16476
Raw Accel -> X: -288 | Y: 40 | Z: 16476
Raw Accel -> X: -336 | Y: 20 | Z: 16304
Raw Accel -> X: -332 | Y: 52 | Z: 16304
Raw Accel -> X: -248 | Y: -16 | Z: 16232
Raw Accel -> X: -264 | Y: 0 | Z: 16284
Raw Accel -> X: -312 | Y: -108 | Z: 15984
Raw Accel -> X: -292 | Y: -60 | Z: 16072
Raw Accel -> X: -228 | Y: -72 | Z: 16212
Raw Accel -> X: -256 | Y: 0 | Z: 16328
Raw Accel -> X: -300 | Y: 12 | Z: 16352
Raw Accel -> X: -304 | Y: 44 | Z: 16388
Raw Accel -> X: -304 | Y: -32 | Z: 16452
Raw Accel -> X: -296 | Y: 48 | Z: 16632
Raw Accel -> X: -348 | Y: 4 | Z: 16592
Raw Accel -> X: -252 | Y: -52 | Z: 16716
Raw Accel -> X: -268 | Y: 24 | Z: 16624
Raw Accel -> X: -272 | Y: -20 | Z: 16648
Raw Accel -> X: -284 | Y: -52 | Z: 16472
Raw Accel -> X: -304 | Y: 48 | Z: 16628
Raw Accel -> X: -344 | Y: -80 | Z: 16412
Raw Accel -> X: -288 | Y: -48 | Z: 16460
Raw Accel -> X: -276 | Y: -56 | Z: 16300
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
Raw Accel -> X: -232 | Y: -28 | Z: 16228
Raw Accel -> X: -224 | Y: 12 | Z: 16144
Raw Accel -> X: -268 | Y: -8 | Z: 16060
Raw Accel -> X: -284 | Y: -60 | Z: 16256
Raw Accel -> X: -296 | Y: -44 | Z: 16228
Raw Accel -> X: -276 | Y: -24 | Z: 16344
Raw Accel -> X: -288 | Y: -44 | Z: 16444
Raw Accel -> X: -260 | Y: -4 | Z: 16396
Raw Accel -> X: -248 | Y: 24 | Z: 16580
Raw Accel -> X: -280 | Y: 16 | Z: 16644
Raw Accel -> X: -292 | Y: -12 | Z: 16604
Raw Accel -> X: -332 | Y: -64 | Z: 16664
Raw Accel -> X: -308 | Y: -16 | Z: 16604
Raw Accel -> X: -360 | Y: -52 | Z: 16492
Raw Accel -> X: -256 | Y: -16 | Z: 16352
Raw Accel -> X: -276 | Y: -12 | Z: 16256
Raw Accel -> X: -268 | Y: -36 | Z: 16196
Raw Accel -> X: -336 | Y: -32 | Z: 16128
Raw Accel -> X: -328 | Y: -8 | Z: 16152
Raw Accel -> X: -304 | Y: -8 | Z: 16192
Raw Accel -> X: -228 | Y: -32 | Z: 16244
Raw Accel -> X: -304 | Y: -16 | Z: 16136
Raw Accel -> X: -324 | Y: -24 | Z: 16220
Raw Accel -> X: -260 | Y: -28 | Z: 16304
