Alireza-Sotoodeh/DeadReckoner/Test- Sanity Check/GY-GPS6Mv2/GY-GPS6Mv2/Result_GY-GPS6Mv2.ino.txt

==============================================
 NEO-6M GPS Diagnostic Tool (Arduino Uno)
==============================================

Initialising SoftwareSerial on RX=2, TX=3
OK. Waiting for satellite lock...
NOTE: Antenna needs clear sky view.
Cold start may take 5-15 minutes.

SATS  QLT  HDOP  LAT          LNG              ALT       SPEED    TIME
----  ---  ----  -----------  --------------  --------  -------  --------
... Searching ...  SATS: 0  CHARS: 2025  AGE: N/A
... Searching ...  SATS: 0  CHARS: 4275  AGE: N/A
... Searching ...  SATS: 0  CHARS: 6525  AGE: N/A
... Searching ...  SATS: 0  CHARS: 8775  AGE: N/A
... Searching ...  SATS: 0  CHARS: 11025  AGE: N/A
... Searching ...  SATS: 0  CHARS: 13275  AGE: N/A
... Searching ...  SATS: 0  CHARS: 15525  AGE: N/A
... Searching ...  SATS: 0  CHARS: 17775  AGE: N/A
... Searching ...  SATS: 0  CHARS: 20025  AGE: N/A
... Searching ...  SATS: 0  CHARS: 22275  AGE: N/A
... Searching ...  SATS: 0  CHARS: 24525  AGE: N/A
... Searching ...  SATS: 0  CHARS: 26817  AGE: N/A
... Searching ...  SATS: 0  CHARS: 29211  AGE: N/A
... Searching ...  SATS: 0  CHARS: 31922  AGE: N/A
... Searching ...  SATS: 0  CHARS: 34665  AGE: N/A
... Searching ...  SATS: 0  CHARS: 37407  AGE: N/A
... Searching ...  SATS: 0  CHARS: 40147  AGE: N/A
... Searching ...  SATS: 0  CHARS: 42900  AGE: N/A
... Searching ...  SATS: 0  CHARS: 45645  AGE: N/A
... Searching ...  SATS: 0  CHARS: 48376  AGE: N/A
... Searching ...  SATS: 0  CHARS: 51136  AGE: N/A
... Searching ...  SATS: 0  CHARS: 53958  AGE: N/A
... Searching ...  SATS: 0  CHARS: 56783  AGE: N/A
... Searching ...  SATS: 0  CHARS: 59765  AGE: N/A
... Searching ...  SATS: 0  CHARS: 62421  AGE: N/A
... Searching ...  SATS: 0  CHARS: 65322  AGE: N/A
... Searching ...  SATS: 0  CHARS: 66494  AGE: N/A
... Searching ...  SATS: 0  CHARS: 68249  AGE: N/A
... Searching ...  SATS: 0  CHARS: 69601  AGE: N/A

--- 5 min Summary ---
Elapsed: 299s
Fixes: 0  Uptime: 100%
SATS  min=99  avg=0.0  max=0
HDOP  min=999  avg=0.0  max=0
---------------------

... Searching ...  SATS: 0  CHARS: 71884  AGE: N/A
... Searching ...  SATS: 0  CHARS: 73507  AGE: N/A
... Searching ...  SATS: 0  CHARS: 74972  AGE: N/A
... Searching ...  SATS: 0  CHARS: 76311  AGE: N/A
... Searching ...  SATS: 0  CHARS: 77475  AGE: N/A
... Searching ...  SATS: 0  CHARS: 78762  AGE: N/A
... Searching ...  SATS: 0  CHARS: 80196  AGE: N/A
... Searching ...  SATS: 0  CHARS: 83194  AGE: N/A
... Searching ...  SATS: 0  CHARS: 86657  AGE: N/A
... Searching ...  SATS: 0  CHARS: 90426  AGE: N/A
... Searching ...  SATS: 0  CHARS: 94002  AGE: N/A
... Searching ...  SATS: 0  CHARS: 96241  AGE: N/A
... Searching ...  SATS: 0  CHARS: 98505  AGE: N/A
... Searching ...  SATS: 0  CHARS: 100971  AGE: N/A
... Searching ...  SATS: 0  CHARS: 105675  AGE: N/A
... Searching ...  SATS: 0  CHARS: 107949  AGE: N/A
... Searching ...  SATS: 0  CHARS: 111933  AGE: N/A
... Searching ...  SATS: 0  CHARS: 114183  AGE: N/A
... Searching ...  SATS: 0  CHARS: 116442  AGE: N/A
... Searching ...  SATS: 0  CHARS: 120864  AGE: N/A
... Searching ...  SATS: 0  CHARS: 123114  AGE: N/A
... Searching ...  SATS: 0  CHARS: 126011  AGE: N/A
... Searching ...  SATS: 0  CHARS: 128260  AGE: N/A
... Searching ...  SATS: 0  CHARS: 130507  AGE: N/A
... Searching ...  SATS: 0  CHARS: 132781  AGE: N/A
... Searching ...  SATS: 0  CHARS: 135090  AGE: N/A
... Searching ...  SATS: 0  CHARS: 137415  AGE: N/A
... Searching ...  SATS: 0  CHARS: 139857  AGE: N/A
... Searching ...  SATS: 0  CHARS: 142515  AGE: N/A
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
... Searching ...  SATS: 0  CHARS: 869807  AGE: 597464ms

--- 5 min Summary ---
Elapsed: 2099s
Fixes: 172  Uptime: 72%
SATS  min=3  avg=6.9  max=8
HDOP  min=181  avg=249.0  max=808
---------------------

... Searching ...  SATS: 0  CHARS: 874505  AGE: 607475ms
