Alireza-Sotoodeh/DeadReckoner/Test- Sanity Check/GY-GPS6Mv2/GPS_ColdStart/Result_GPS_ColdStart.txt

==============================================
 NEO-6M — Cold Start Timing & Fix Reliability
==============================================

Phase 1: COLD START — waiting for first 3D fix...
(Ensure antenna has clear sky view)

>>> COLD START TTFF: 4 sec

Phase 2: Stabilisation — logging for 120 s...
SATS  HDOP  LAT          LNG           ALT   AGE
----  ----  -----------  -----------  -----  ---
 5  229  29.454868  55.674999  1740.6  104ms
 5  229  29.454822  55.675010  1740.6  35ms
 5  229  29.454822  55.675010  1740.8  35ms
 5  229  29.454790  55.674999  1740.8  34ms
 6  210  29.454790  55.674999  1741.3  36ms
 6  210  29.454780  55.674976  1741.3  35ms
 7  167  29.454780  55.674976  1739.3  35ms
 7  167  29.454780  55.674961  1739.3  36ms
 8  165  29.454780  55.674961  1738.1  35ms
 8  165  29.454795  55.674957  1738.1  35ms
 8  165  29.454795  55.674957  1738.7  35ms
 8  165  29.454803  55.674949  1738.7  36ms
 8  165  29.454803  55.674949  1738.4  35ms
 8  165  29.454801  55.674942  1738.4  36ms
 8  165  29.454801  55.674942  1738.3  37ms
 8  165  29.454801  55.674938  1738.3  35ms
 8  165  29.454801  55.674938  1738.8  35ms
 8  165  29.454801  55.674942  1738.8  37ms
 8  165  29.454801  55.674942  1739.8  37ms
 8  165  29.454801  55.674945  1739.8  36ms
 8  165  29.454801  55.674945  1740.8  34ms
 8  165  29.454799  55.674945  1740.8  36ms
 8  165  29.454799  55.674945  1741.3  37ms
 8  165  29.454795  55.674942  1741.3  37ms
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
HDOP        min=163  avg=173.3  max=237

Position stability (2 min stationary):
  Lat:  29.454725  ± 1.84 m
  Lon:  55.674865  ± 2.96 m
  Alt:  1741.2 m  [1738.1 – 1744.6 m]
==============================================
 TEST COMPLETE.
==============================================
