Alireza-Sotoodeh/DeadReckoner/Test- Sanity Check/BMP280/BMP280_DriftTest/Result_BMP280_DriftTest.txt

===============================================
 BMP280 � 5-Minute Drift & Altitude Test
===============================================

Logging for 300 seconds at 1 Hz...
Open Tools -> Serial Plotter for live graph.

time_s, temp_C, pressure_hPa, altitude_m
1, 35.05, 827.18, 1679.0
2, 35.05, 827.18, 1679.0
3, 35.05, 827.18, 1679.0
4, 35.05, 827.18, 1679.0
5, 35.05, 827.18, 1679.0
6, 35.05, 827.18, 1679.0
7, 35.05, 827.18, 1679.0
8, 35.05, 827.18, 1679.0
9, 35.05, 827.18, 1679.0
10, 35.05, 827.18, 1679.0
11, 35.05, 827.18, 1679.0
12, 35.05, 827.18, 1679.0
13, 35.05, 827.18, 1679.0
14, 35.05, 827.18, 1679.0
15, 35.05, 827.18, 1679.0
16, 35.05, 827.18, 1679.0
17, 35.05, 827.18, 1679.0
18, 35.05, 827.18, 1679.0
19, 35.05, 827.18, 1679.0
20, 35.05, 827.18, 1679.0
21, 35.05, 827.18, 1679.0
22, 35.05, 827.18, 1679.0
23, 35.05, 827.18, 1679.0
24, 35.05, 827.18, 1679.0
25, 35.05, 827.18, 1679.0
26, 35.05, 827.18, 1679.0
27, 35.05, 827.18, 1679.0
28, 35.05, 827.18, 1679.0
29, 35.05, 827.18, 1679.0
30, 35.05, 827.18, 1679.0
31, 35.05, 827.18, 1679.0
32, 35.05, 827.18, 1679.0
33, 35.05, 827.18, 1679.0
34, 35.05, 827.18, 1679.0
35, 35.05, 827.18, 1679.0
36, 35.05, 827.18, 1679.0
37, 35.05, 827.18, 1679.0
38, 35.05, 827.18, 1679.0
39, 35.05, 827.18, 1679.0
40, 35.05, 827.18, 1679.0
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

===============================================
 DRIFT TEST SUMMARY
===============================================
Elapsed: 300 s

Temperature [
]:  min = 35.05,  max = 35.05,  mean = 35.05,  SD = 0.073
Pressure [hPa]:    min = 827.2,  max = 827.2,  mean = 827.2,  SD = 0.084
Altitude [m]:      min = 1679.0,  max = 1679.0,  mean = 1679.0,  SD = 0.00

Trend:  temp = 0.0000 
/min  (stable)
Trend:  pressure = 0.0000 hPa/min  (stable)

-----------------------------------------------
 ALTITUDE CHECK
  Measured mean altitude:  1679.0 m
  Reference altitude:      1741.0 m
  Delta:                    62.0 m
  VERDICT: PASSED.
===============================================
 TEST COMPLETE.
===============================================
