Alireza-Sotoodeh/DeadReckoner/Code_deadreckoner/Matlab/2-test result/3-Vibration Rejection/3_Vibration_Rejection.csv

Time_s | Qw | Qx | Qy | Qz
5.45 | 1.000000 | 0.000000 | 0.000000 | 0.000000
6.95 | 0.797926 | 0.027320 | 0.062073 | -0.598928
8.46 | 0.460312 | 0.006915 | 0.026163 | -0.887345
9.96 | 0.298730 | -0.000807 | 0.006516 | -0.954315
11.46 | 0.244702 | -0.002519 | 0.001943 | -0.969593
12.97 | 0.234197 | -0.003401 | -0.002207 | -0.972181
14.48 | 0.229442 | -0.003076 | -0.002014 | -0.973315
15.98 | 0.232850 | -0.003172 | -0.003041 | -0.972503
17.49 | 0.226883 | -0.003091 | -0.002670 | -0.973914
18.99 | 0.234440 | -0.003248 | -0.003036 | -0.972120
20.50 | 0.228679 | -0.003328 | -0.003455 | -0.973490
22.00 | 0.228863 | -0.002369 | -0.000473 | -0.973456
23.50 | 0.232076 | -0.002855 | -0.002217 | -0.972691
25.01 | 0.230619 | -0.002902 | -0.001303 | -0.973039
26.51 | 0.235469 | -0.003392 | -0.003336 | -0.971870
28.02 | 0.231537 | -0.003475 | -0.002167 | -0.972817
29.52 | 0.233705 | -0.003468 | -0.003028 | -0.972297
31.03 | 0.230347 | -0.003248 | -0.003259 | -0.973098
32.54 | 0.233532 | -0.003496 | -0.002502 | -0.972340
34.04 | 0.233459 | -0.003145 | -0.002905 | -0.972357
35.55 | 0.234009 | -0.002868 | -0.001802 | -0.972228
37.05 | 0.232290 | -0.003090 | -0.002774 | -0.972638
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
