Alireza-Sotoodeh/DeadReckoner/Code_deadreckoner/Matlab/2-test result/2-Dynamic Return-to-Zero/2_Dynamic_Return_to_Zero.csv

Time_s | Qw | Qx | Qy | Qz
4.44 | 1.000000 | 0.000000 | 0.000000 | 0.000000
5.90 | 0.798031 | 0.033465 | 0.041845 | -0.600230
7.40 | 0.573889 | 0.008618 | 0.011015 | -0.818814
8.91 | 0.498647 | 0.001728 | 0.000785 | -0.866803
10.41 | 0.482401 | 0.000477 | -0.001611 | -0.875949
11.92 | 0.477396 | 0.000520 | -0.001646 | -0.878687
13.42 | 0.477102 | 0.000163 | -0.002157 | -0.878845
14.93 | 0.475952 | 0.000345 | -0.001983 | -0.879469
16.43 | 0.476056 | 0.000421 | -0.001882 | -0.879413
17.94 | 0.477353 | 0.000383 | -0.002299 | -0.878709
19.45 | 0.478433 | 0.000679 | -0.001731 | -0.878122
20.95 | 0.476598 | -0.000098 | -0.002425 | -0.879118
22.45 | 0.477489 | 0.000226 | -0.002004 | -0.878635
23.96 | 0.476598 | -0.000350 | -0.002960 | -0.879116
25.46 | 0.477805 | 0.000027 | -0.002450 | -0.878463
26.96 | 0.477034 | 0.000255 | -0.002061 | -0.878882
28.47 | 0.479612 | -0.000124 | -0.002824 | -0.877476
29.98 | 0.478007 | -0.000366 | -0.002357 | -0.878353
31.48 | 0.476577 | 0.000027 | -0.002730 | -0.879128
32.99 | 0.476732 | 0.000571 | -0.002111 | -0.879046
34.49 | 0.479354 | -0.000036 | -0.002494 | -0.877618
36.00 | 0.477582 | 0.000275 | -0.001957 | -0.878585
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
