Alireza-Sotoodeh/DeadReckoner/Code_deadreckoner/Matlab/2-test result/1-Static_Drift/1- Static_Drift_Log.csv

Time_s | Qw | Qx | Qy | Qz
4.86 | 1.000000 | 0.000000 | 0.000000 | 0.000000
6.34 | 0.796403 | 0.030146 | 0.050860 | -0.601869
7.85 | 0.511929 | 0.007960 | 0.018096 | -0.858800
9.35 | 0.390252 | 0.001318 | 0.004050 | -0.920698
10.86 | 0.356003 | -0.000923 | -0.000811 | -0.934484
12.36 | 0.351732 | -0.001885 | -0.002335 | -0.936096
13.87 | 0.350803 | -0.001463 | -0.001554 | -0.936447
15.37 | 0.351288 | -0.001767 | -0.002286 | -0.936263
16.88 | 0.351862 | -0.001389 | -0.001846 | -0.936049
18.38 | 0.350471 | -0.001506 | -0.002476 | -0.936569
19.89 | 0.347750 | -0.001613 | -0.002259 | -0.937583
21.39 | 0.352339 | -0.001577 | -0.002529 | -0.935868
22.90 | 0.351684 | -0.001321 | -0.001022 | -0.936117
24.40 | 0.355497 | -0.002031 | -0.002989 | -0.934670
25.91 | 0.352161 | -0.001733 | -0.002029 | -0.935936
27.41 | 0.351458 | -0.001922 | -0.002847 | -0.936197
28.92 | 0.352261 | -0.001725 | -0.001561 | -0.935899
30.44 | 0.355444 | -0.001137 | -0.001697 | -0.934695
31.93 | 0.357329 | -0.000673 | -0.000662 | -0.933978
33.43 | 0.355586 | -0.000935 | -0.000876 | -0.934643
34.93 | 0.356588 | -0.000423 | -0.001386 | -0.934261
36.44 | 0.354265 | -0.001473 | -0.002475 | -0.935141
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
