Alireza-Sotoodeh/DeadReckoner/Code_deadreckoner/Matlab/2-test result/1-Static_Drift/1- Static_Drift_Log.png

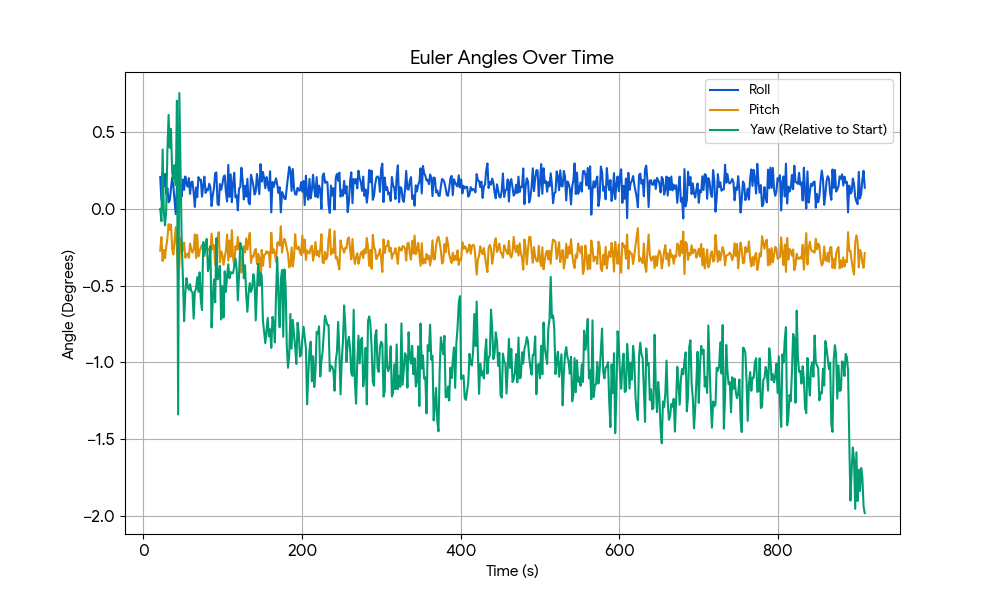
Code_deadreckoner/Matlab/2-test result/1-Static_Drift/1- Static_Drift_Log.png
