Alireza-Sotoodeh/DeadReckoner/Code_deadreckoner/Matlab/2-test result/2-Dynamic Return-to-Zero/Dynamic_Return_to_Zero-2.png

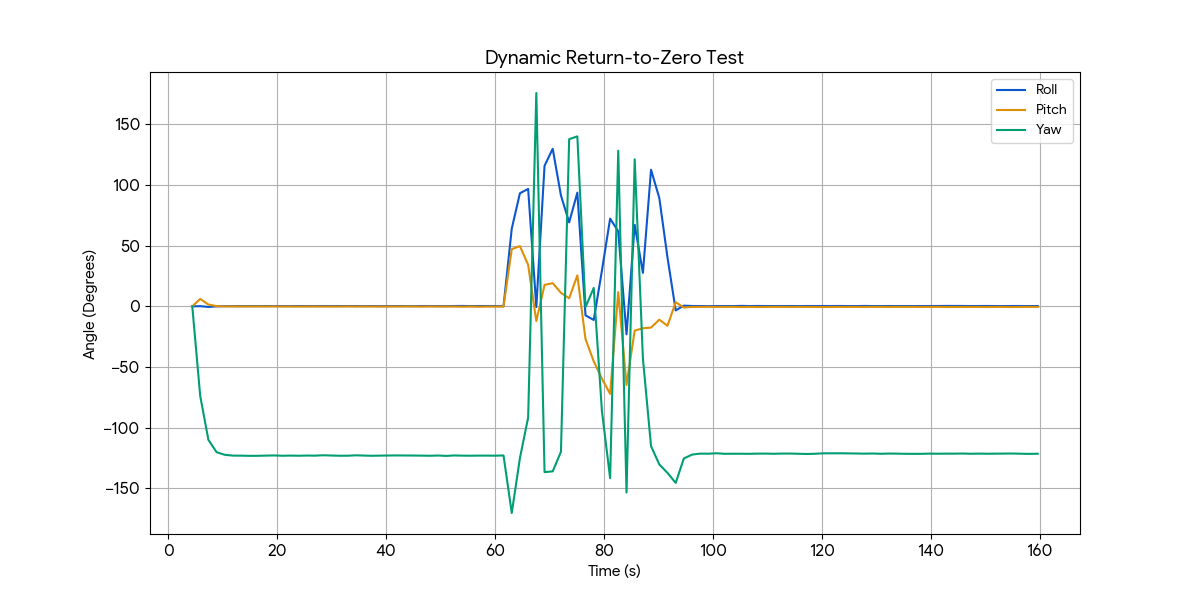
Code_deadreckoner/Matlab/2-test result/2-Dynamic Return-to-Zero/Dynamic_Return_to_Zero-2.png
