Alireza-Sotoodeh/DeadReckoner/Code_deadreckoner/Matlab/2-test result/3-Vibration Rejection/Vibration_Rejection_1.png

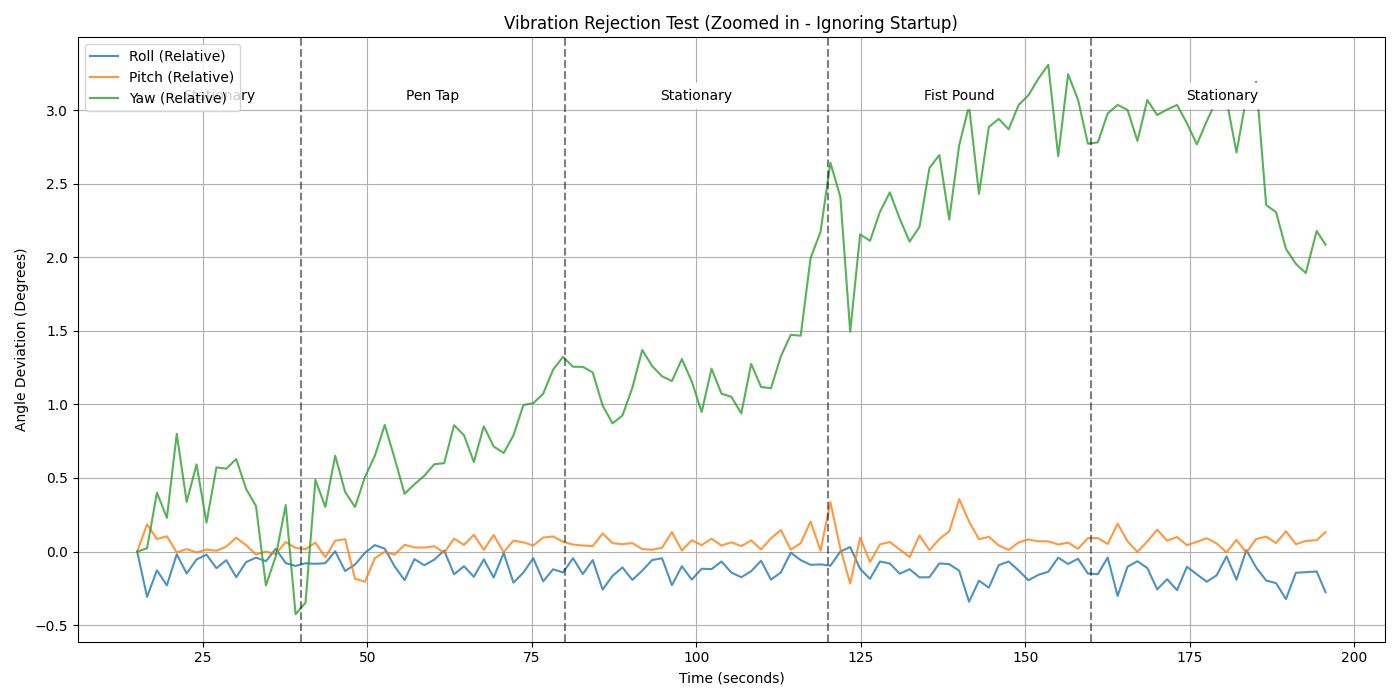
Code_deadreckoner/Matlab/2-test result/3-Vibration Rejection/Vibration_Rejection_1.png
