Alireza-Sotoodeh/DeadReckoner/Code_deadreckoner/Matlab/3-BinReader/Tests/2-test the recovery without PSRAM/1-test the recovery.png

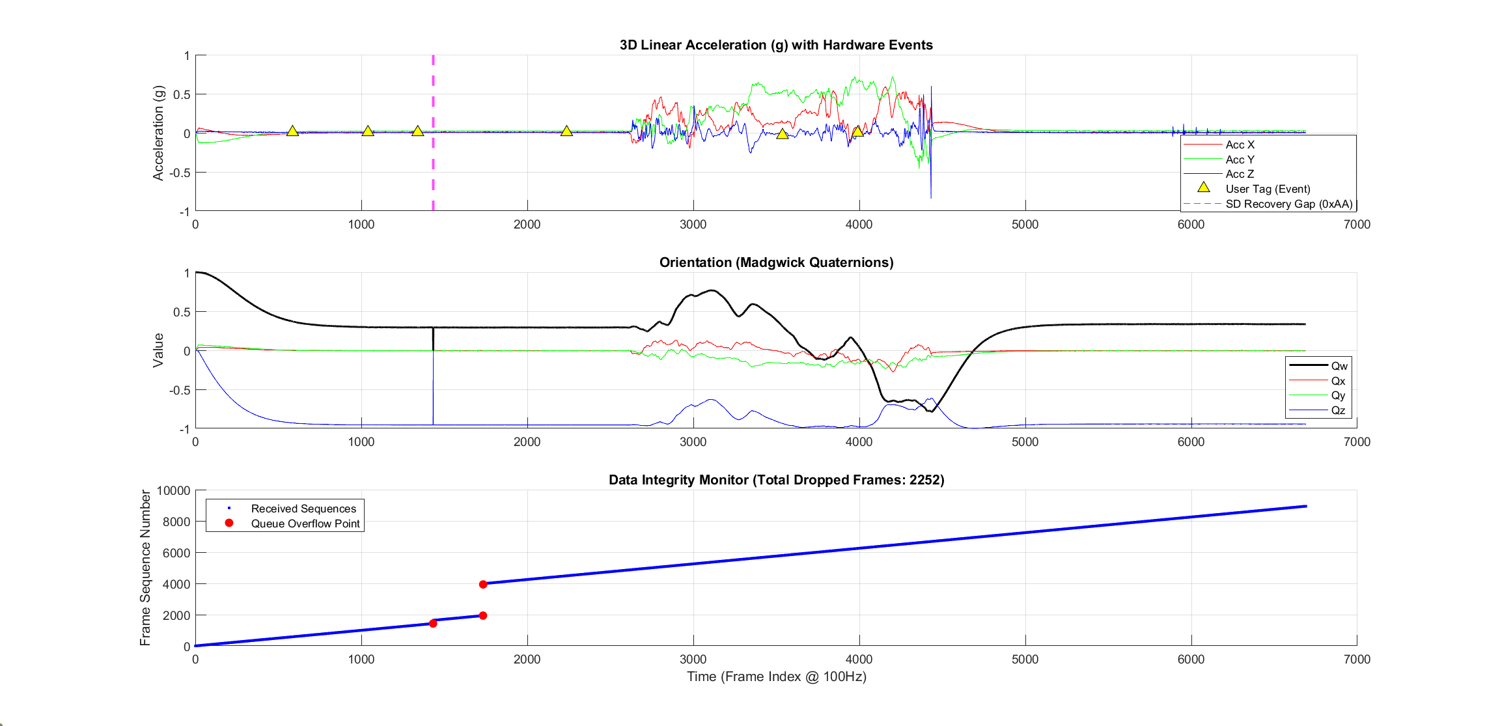
Code_deadreckoner/Matlab/3-BinReader/Tests/2-test the recovery without PSRAM/1-test the recovery.png
