Alireza-Sotoodeh/DeadReckoner/Code_deadreckoner/Matlab/3-BinReader/Tests/3-test recovery with PSRAM- cant glue back/3.png

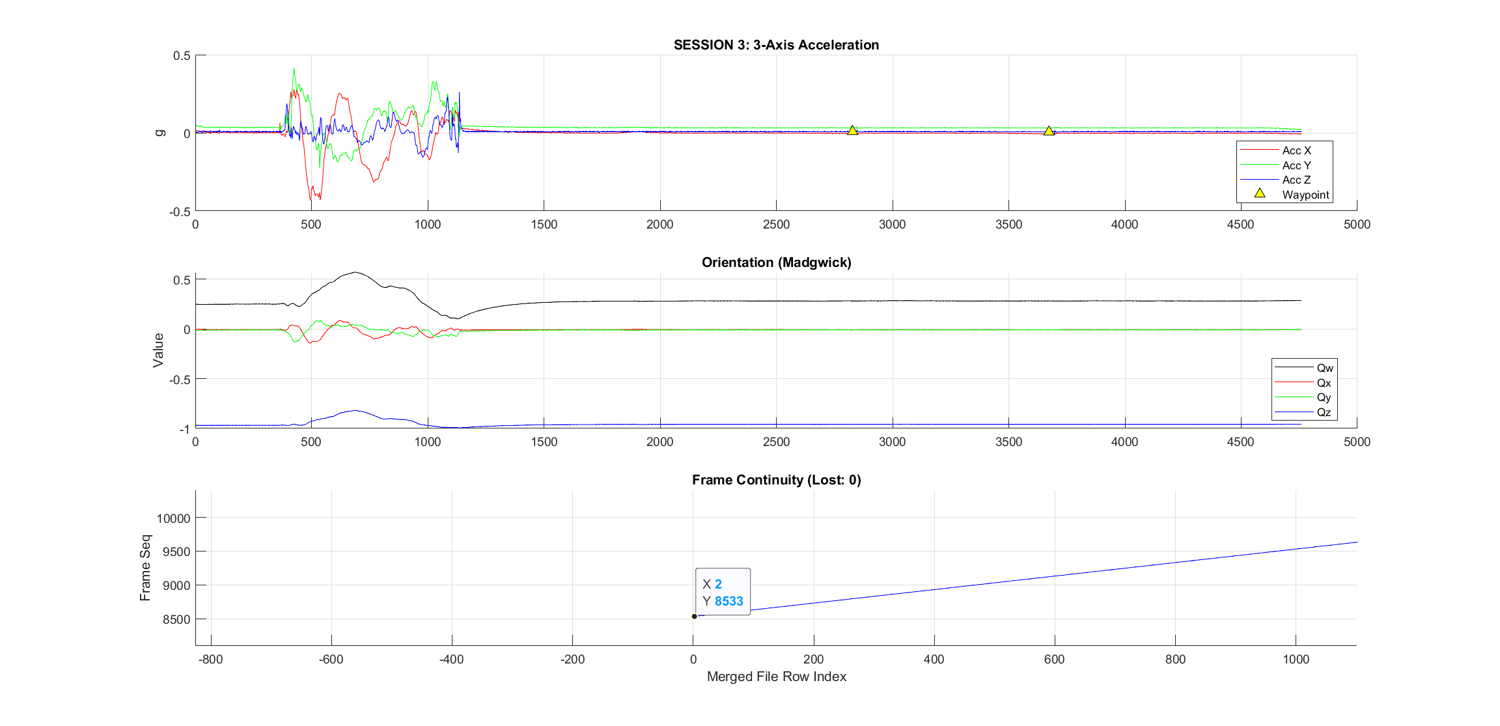
Code_deadreckoner/Matlab/3-BinReader/Tests/3-test recovery with PSRAM- cant glue back/3.png
