Alireza-Sotoodeh/DeadReckoner/Code_deadreckoner/Matlab/3-BinReader/Tests/4-test recovery with PSRAM/1.png

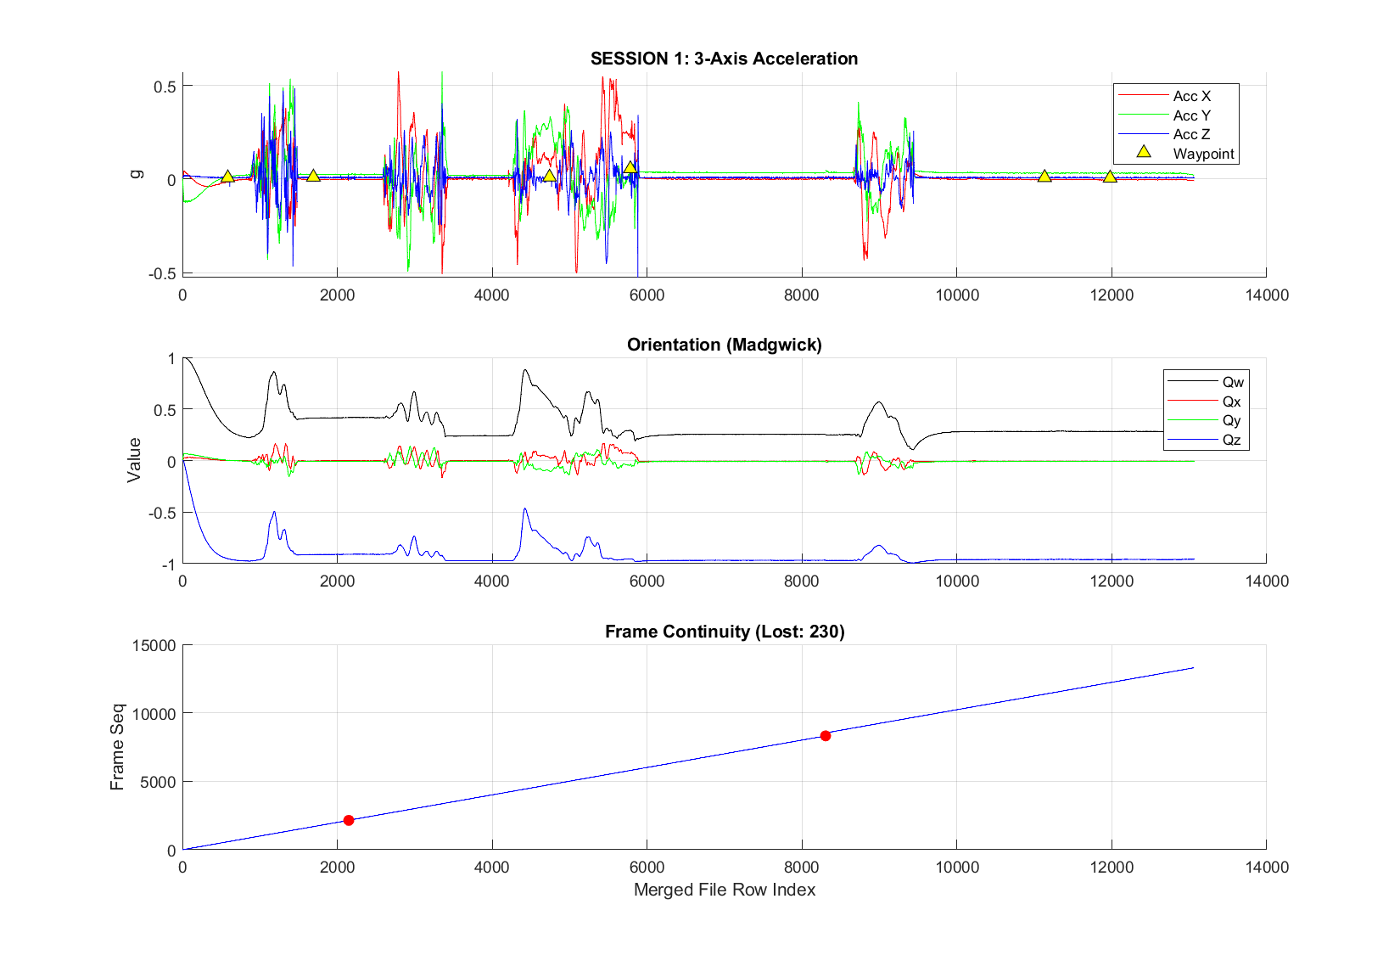
Code_deadreckoner/Matlab/3-BinReader/Tests/4-test recovery with PSRAM/1.png
