Alireza-Sotoodeh/DeadReckoner/Collectd Data/2026-21-6-6AM/analysis/2-tune PDR/error_vs_K.png

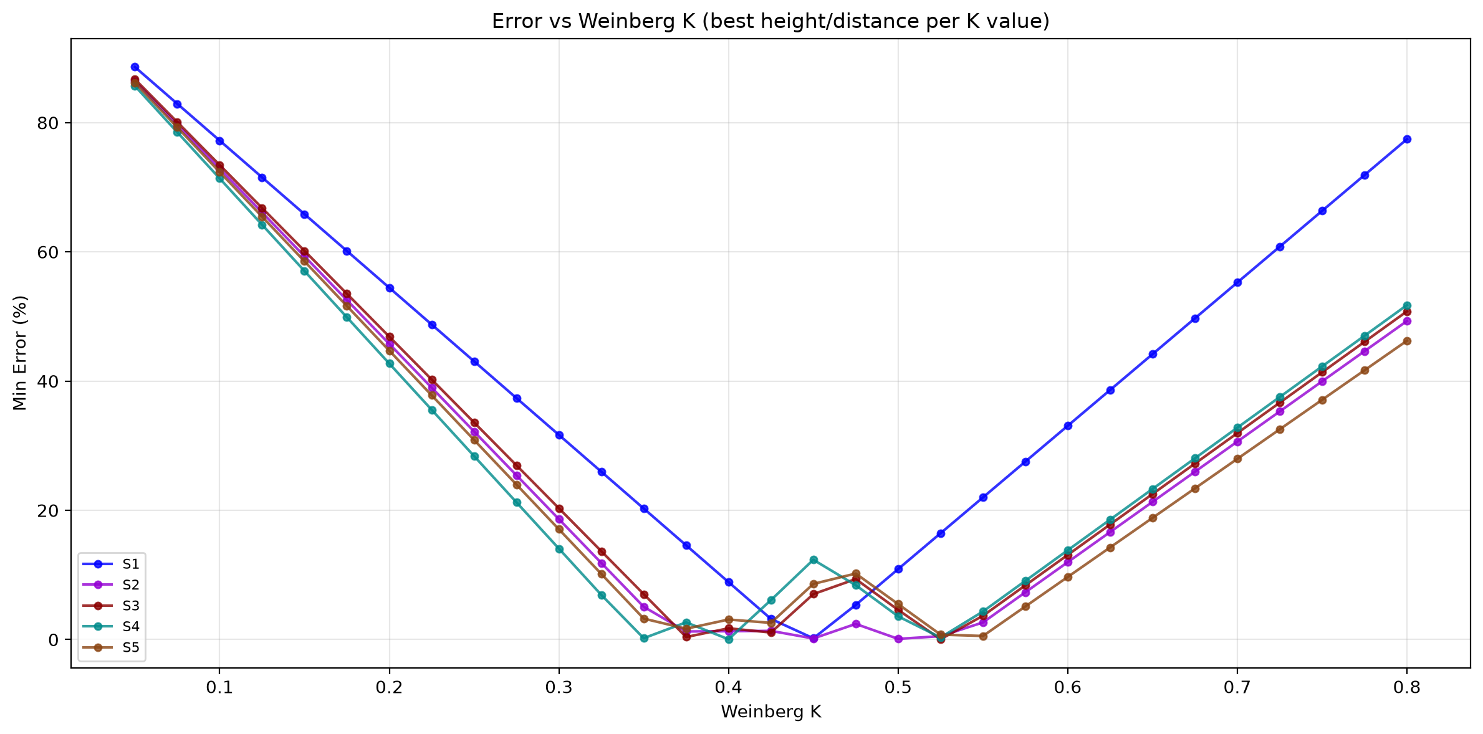
Collectd Data/2026-21-6-6AM/analysis/2-tune PDR/error_vs_K.png
