Alireza-Sotoodeh/DeadReckoner/Collectd Data/2026-21-6-6AM/analysis/2-tune PDR/heatmap_s2.png

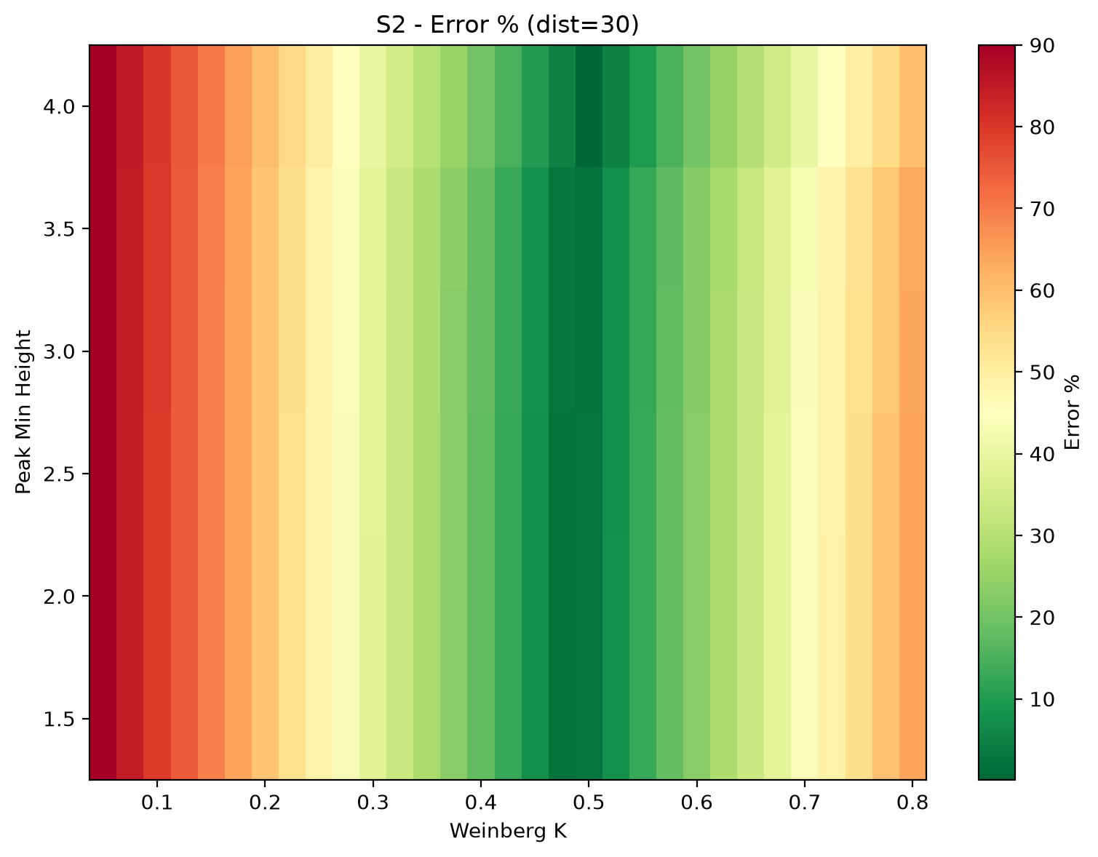
Collectd Data/2026-21-6-6AM/analysis/2-tune PDR/heatmap_s2.png
