Alireza-Sotoodeh/DeadReckoner/Collectd Data/2026-21-6-6AM/analysis/2-tune PDR/optimal_comparison.png

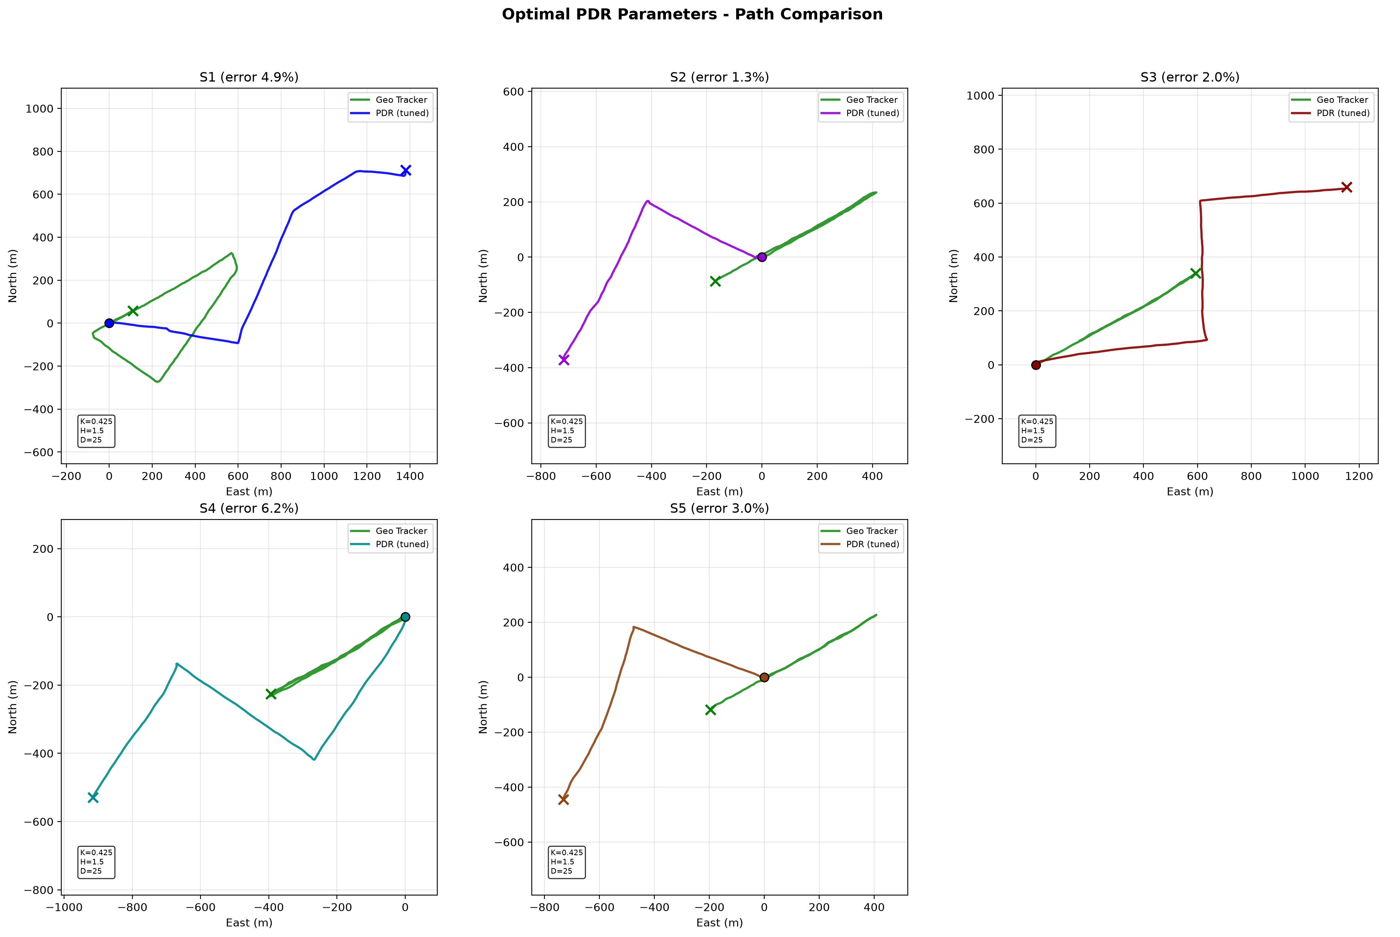
Collectd Data/2026-21-6-6AM/analysis/2-tune PDR/optimal_comparison.png
