Alireza-Sotoodeh/DeadReckoner/Collectd Data/2026-21-6-6AM/analysis/5-fix/summary_comparison.png

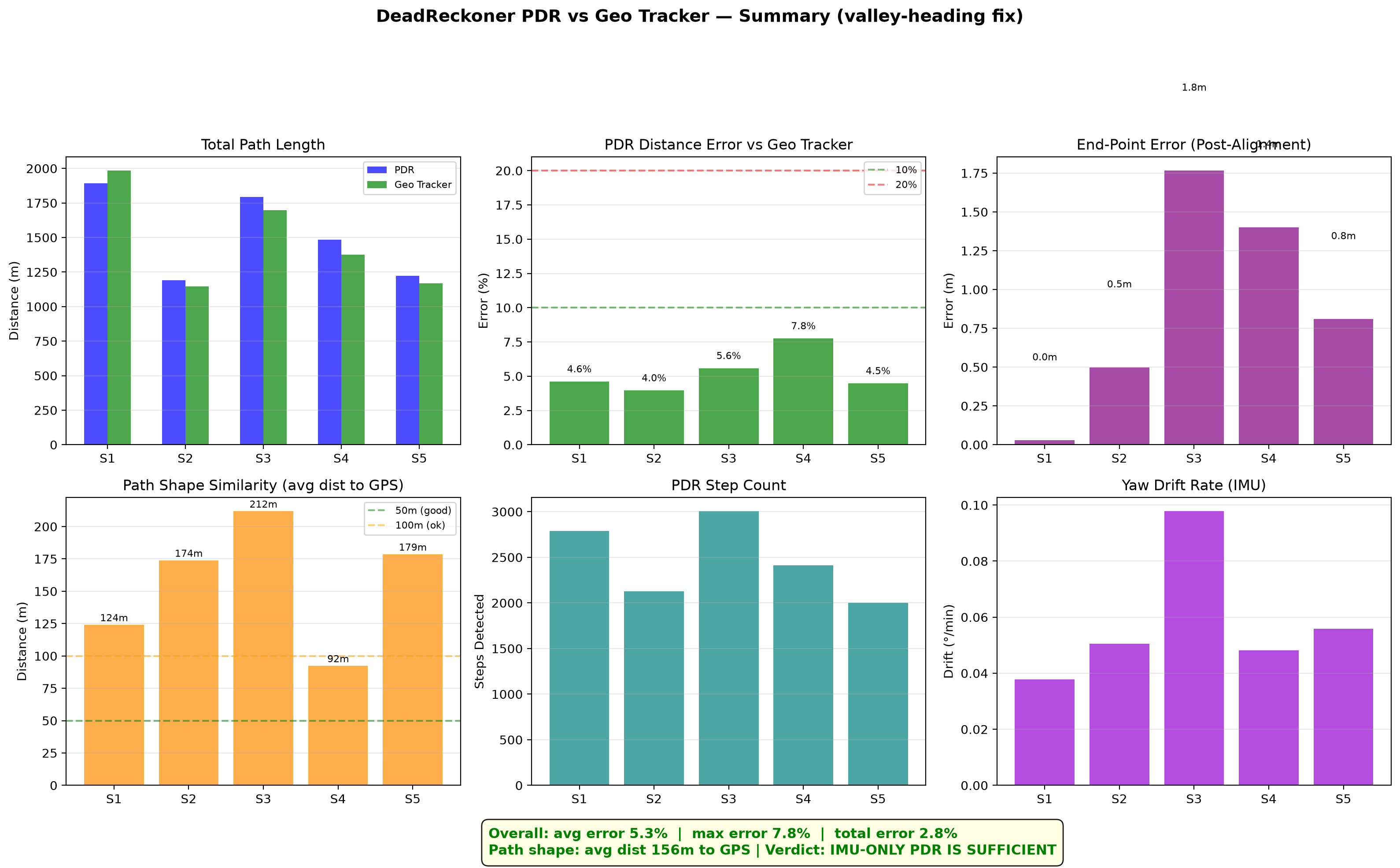
Collectd Data/2026-21-6-6AM/analysis/5-fix/summary_comparison.png
