Alireza-Sotoodeh/DeadReckoner/(commit log)

2025-07-13 adding scr MPU6500
    driver and interface files has been added
2025-07-18 04/27-10:48 AM
    Refactor and enhance MPU6500 inertial navigation code
    - Fixed duplicate `mpu6500_receive_callback` definition in `main.c` to resolve compilation error.
    - Removed redundant `mpu6500_dmp_init` call in `main.c` for robust initialization with retry logic.
    - Improved error handling in `main.c` and `driver_mpu6500_dmp.c` with detailed debug messages and context.
    - Added FIFO overflow handling and sensor data validation in `mpu6500_receive_callback`.
    - Implemented EXTI interrupt handler for MPU6500 data ready interrupts.
    - Set MPU6500 low-pass filter to `MPU6500_LOW_PASS_FILTER_2` in `driver_mpu6500_dmp.c` for better dynamic response.
    - Removed redundant FIFO configuration in `drive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
2025-07-18 04/27-6:03 PM
    - fixed readme file
    - Optimize full-scale accelerometer/gyro ranges (set to ±8g and ±1000dps for dynamic environments)
    - Increase sample rate to 200 Hz (and editing the driver_MPU6500_dmp.c)
2025-07-25 Add DMP.c for MPU_9250 and update workspace state
    Added the new DMP.c module for the MPU_9250 sensor in setup modules/DataSheets/MPU_9250/. Updated Eclipse workspace state to reflect recent file activity and editor state.
2025-08-03 05/12-3:34PM
    test the MPU9250 and filter and 3d visualization by Arduino and MATLAB
2025-08-05 05/14_7:33PM
    fixed MPU9250 comments and settings
    [nodeMUC8266.ino]
2025-08-07 05/16-12:26PM
    fixed the MATLAB code (closing the serial on exit)
    [nodeMUC8266.ino]
2026-06-03 added wiring diagram for ESP
2026-06-04 Updated wiring diagram
2026-06-04 Basic I2C sanity check MPU9250
2026-06-04 Firmware Flashing Configuration (ESP32-S3 N16R8)
2026-06-04 ix issues before test
    Fixed EEPROM load bug (added setters) and migrated OLED to Hardware I2C (Wire1).
    [ESP32_S3.ino]
2026-06-04 Drift Test Visualizer
    [1- Static_Drift_Log.csv]
2026-06-04 Clean up and add a second test (Dynamic Return-to-Zero)
    [1- Static_Drift_Log.csv, 2_Dynamic_Return_to_Zero.csv]
2026-06-04 Vibration Rejection test result
    [3_Vibration_Rejection.csv]
2026-06-04 Hardware & Filter Validation (Test Results)
2026-06-05 Sanity Check for SPI SD Card Module
2026-06-05 Standalone Sanity Check for SPI SD Card Module
2026-06-08 added SD card test (all methods has been failed)
    [DIY_SDCardAdaptor.ino]
2026-06-10 try to update oled-phase 4
    1- added return home (if in sleep mode)
    2- sleep oled after some time to save power
2026-06-11 added buzzer and LED for Tag and SD card failure
    [ESP32_S3.ino]
2026-06-11 update menu - mute buzzer menu
    [ESP32_S3.ino]
2026-06-11 update menu - SD card sub menu
    Total: XX.X GB
    Free: XXXX MB
    Time: XX.X Hrs
    Files Count: XX
    Create New File
    Format / Clear
    Back to Menu
    i should fix (Total: XX.X GB)
    [ESP32_S3.ino]
2026-06-11 fix (Total: XX.X GB) in submenu SD card
    [ESP32_S3.ino]
2026-06-11 implement MPU9250 critical disconnect trap and boot-time SD scanning
    Implemented a robust critical error handling mechanism for the MPU9250 sensor. The system now monitors I2C communication; upon a disconnection, it safely syncs/closes the log file and enters an infinite SOS loop with visual/audible alerts. Added a boot-time scanning sequence for the SD card to display existing log counts and the next filename, providing better pre-mission feedback. Removed legacy calibration prompts to streamline the startup sequence.
    [ESP32_S3.ino]
2026-06-12 Update To Do list with finding the final issues
    Expand the project To Do list with runtime recovery items and hardware considerations. Added SD card "Runtime Failure" and SD Dynamic Recovery, MPU9250 Dynamic Recovery and an mpu_critical_error item for calibration; clarified safe shutdown and software solution. Added Queue Overflow handling suggestion (use frame_sequence_number instead of timestamp in LogFrame), GPS logging rate fix (100Hz -> 1Hz), watchdog consideration, BMP280 for Z-axis deficits, and change recommendation for GPIO9/10 (flash/strapping pins). New "Hardware challenges" section covers brownout mitigation (capacitance recommendations), I2C pull-up resistor (4.7k for MPU9250),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
2026-06-12 SD runtime recovery and pin remap
    Implement dynamic SD-card runtime recovery and remap a few unsafe pins. Adds attemptSDRecovery() and an sd_critical_error interceptor that detects write/sync failures, retries SPI re-init, reopens the same filename for append, and injects a gap recovery frame into the log when recovery succeeds. Introduces current_log_filename, recovery timing macros (Attempt_Runtime_SD_recovery_MS, Recheck_SD_beforeBoot_MS), and UI/LED/buzzer feedback during SD error retries. Also reorganizes pin/setting blocks, moves SD CS from GPIO10 to GPIO15, moves TAG button from GPIO9 to GPIO14, refactors LogFrame to use frame_seq, adds a global frame counter and related MPU retry tim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
    [ESP32_S3.ino]
2026-06-12 Reorganize MATLAB files and add BIN parser
    Restructure project layout and add tools for log analysis.
    - Move visualization scripts into Code_deadreckoner/Matlab/1-Visual (Visual.m, visual_v2.m) and add DR_LOG_001.BIN sample.
    - Reorganize test result folders into Code_deadreckoner/Matlab/2-test result/ (Static_Drift, Dynamic Return-to-Zero, Vibration Rejection) to better group outputs.
    - Relocate BinReader samples into Code_deadreckoner/Matlab/BinReader/data/1-first log/ and add a new recovery dataset under data/2-test the recovery (DR_LOG_001.BIN and 1-test the recovery.png).
    - Add BinReader/data/2-test the recovery/v2.m: a new MATLAB parser/diagnostics script that decodes the 49-byte packe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
    [1- Static_Drift_Log.csv, 2_Dynamic_Return_to_Zero.csv, 3_Vibration_Rejection.csv]
2026-06-12 Add PSRAM recovery test data and v3 MATLAB reader
    Add test dataset and a new MATLAB reader for PSRAM recovery testing. Files added under data/3-test recovery with PSRAM: three PNGs, DR_LOG_001.BIN, REC_001.BIN, REC_002.BIN, ResutCommandWindow.txt (sample run output), and v3.m. The v3.m script implements a Relational Sequence Chaining (Greedy Stitcher) to automatically merge crashed SD sessions without an RTC, extracts frame metadata, stitches fragments by sequence numbers (with safety gap checks), decodes IMU/orientation payloads, computes session stats (merged frames, recovery gaps, missing frames) and generates diagnostic plots.
2026-06-12 Move BinReader data to Tests and add v4
    Reorganize test artifacts by moving existing sample logs and MATLAB test scripts from data/... into Tests/... directories. Add a new test set (Tests/4-test recovery with PSRAM) containing additional .BIN and .png files, and introduce Code_deadreckoner/Matlab/BinReader/v4.m.
    v4.m implements an improved merge-and-decoding flow: replaces strict sequence matching with an Absolute Distance Minimizer for smart stitching, adds a garbage-frame filter to trim corrupted SD-card tails, supports overlap allowances for PSRAM cases, and produces payload decoding, diagnostics and plots (acceleration, orientation, frame continuity) with drop/gap detection.
2026-06-12 Optimize LogFrame, add PSRAM queue & SD recovery
    Reduce LogFrame size by introducing a packed union payload to overlap IMU and GPS fields (forced 1-byte alignment), and update all producers/consumers to use the union layout. Add esp_heap_caps.h and implement a large PSRAM-backed static FreeRTOS queue (QUEUE_LENGTH = 50000) via heap_caps_malloc + xQueueCreateStatic, with fatal error handling if PSRAM allocation fails. Revise SD recovery to create REC_ prefixed recovery files and update current_log_filename, and adjust gap-frame clearing to zero the union payload correctly. Also update OLED display formatting for the new payload layout and minor housekeeping (last-edit comment).
    [ESP32_S3.ino]
2026-06-12 Report: update To Do list tasks and notes
    Mark several checklist items as done and add MPU9250 recovery details. SD card runtime failure and GPIO9/10 pin change were checked off. MPU9250 section was expanded and partially completed: keep data by using Frame Sequence + Gap Frame, switch to PSRAM and a compact save format, and add MATLAB code to reassemble fragments. Added an OLED power-reset issue entry, cleaned up formatting and minor checklist reordering.
2026-06-12 Mark Queue Overflow and 100Hz write fix done
    Update Report/To Do list.md to mark the 'Queue Overflow' task and the 'remove 100HZ writing and fix it for 1HZ (memory usage issue)' task as completed. Minor formatting/spacing adjusted in the checklist; no functional code changes.
2026-06-13 Add global log/recovery IDs and improved recovery naming
    Introduce global_log_id and global_recovery_id to track main log number (X) and recovery instance (Y). Use these to generate recovery filenames ("%03d%03d.BIN") during SD recovery for O(1) name generation, display the active recovery filename to the user, and increment/reset counters appropriately across startup, new-file creation, clearing, and recovery flows.
    Other changes: update SD root scan to use global_log_id, count both main and recovery-style files when estimating total files, reset/clear queues and UI flags at appropriate points, add a brief UI pause to show recovery feedback, and minor cleanup of comments and LED/buzzer con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
    [ESP32_S3.ino]
2026-06-13 Move BinReader tests, add V5, tighten jump filter
    Reorganize BinReader test assets into Code_deadreckoner/Matlab/3-BinReader/Tests (many test files and images renamed/moved) and add a new set of recovery test artifacts. Reduce the garbage-filter jump threshold in v4.m (jumps > 50000 -> jumps > 500) to detect smaller sequence gaps. Add a new V5.m: a rewritten BinReader pipeline that chains DR_LOG and recovery files, decodes packed frames, computes diagnostics (drops, RMS, stats), plots session summaries, and includes robustness fixes (sessionData naming, drop detection, clamp helper).
2026-06-13 Improve SD runtime recovery and UI feedback
    Add a small SD_recoverd_signal_MS macro and rework the runtime SD-card recovery path to be non-blocking and more user-friendly. Introduces a hardware alarm layer that pulses the red LED and buzzer (100ms on every 1000ms) while in SD failure state, and keeps that rhythm independent of slower recovery attempts. Recovery attempts are gated by Attempt_Runtime_SD_recovery_MS to avoid repeated sd.begin() timeouts; when recovery runs it wakes the display, shows the active filename, resets LEDs to green briefly, and uses SD_recoverd_signal_MS for the brief user-visible pause. Loop yields reduced to 10ms to prevent watchdog starvation while preserving the r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
    [ESP32_S3.ino]
2026-06-13 Display elapsed time instead of frame seq
    Replace the raw frame sequence number with a human-readable elapsed time computed from frame_seq assuming a 100 Hz frame rate. The code now divides frame_seq by 100 to get total seconds, derives minutes and seconds, and formats them as T:MMM:SS (zero-padded) at the same display position. The MPU temperature display is left unchanged.
    [ESP32_S3.ino]
2026-06-13 Add safe long-press shutdown and SD flush
    Introduce a safe shutdown sequence triggered by a long press of the SELECT button. Added Press_to_ShutDown_MS (3000ms) and a volatile system_shutdown_requested flag; sensorTask will pause data generation when shutdown is requested. loggingTask now implements a smart long-press detector: holding SELECT for the threshold wakes the display, shows status, drains remaining frames from the PSRAM/data queue to the open log file, syncs and closes the file, updates LEDs/UI, and then halts the system loop to ensure it is safe to power off. Also adjusted short-press behavior to only trigger on quick releases to avoid accidental immediate actions.
    [ESP32_S3.ino]
2026-06-13 Use global frame counter and reset on log events
    Introduce a volatile global_frame_counter and remove the local shadowed variable in sensorTask to ensure a single frame counter shared across tasks. Reset global_frame_counter when starting a new log, after recovery/rollover, and during setup so frame numbering is consistent across sessions. Also includes minor whitespace/comment cleanups.
    [ESP32_S3.ino]
2026-06-13 Remove parent logs and nested recovery fragments
    Enhance log-sweeping routine to delete both parent log files (DR_LOG_%03d.BIN) and any sequential child recovery fragments (%03d%03d.BIN). Iterates parent IDs 1–999 and for each parent loops over child fragments incrementing j until no more fragments exist, removing each found file. This prevents orphaned recovery chunks from accumulating on the SD card after crashes or rollovers and then resets the current log filename and global log/recovery IDs.
    [ESP32_S3.ino]
2026-06-13 Fix SD capacity overflow on large cards
    Cast cluster*sector multiplication to 64-bit to avoid 32-bit overflow on large SD cards (>32GB). sd_free_mb and sd_total_mb are now computed from (uint64_t)freeClusters/totalClusters before division, preventing incorrect capacity values. Kept existing remaining-hours and GB calculations unchanged. Also cleaned up minor stray whitespace and preserved existing file/count resets and menu cursor initialization.
    [ESP32_S3.ino]
2026-06-13 Remove xQueueReset to avoid race condition
    Delete the call to xQueueReset(dataQueue) in loggingTask and add a comment explaining the reason: resetting the queue could race with Core 0 which is buffering valid pre-fusion IMU frames, causing those frames to be lost. This preserves recently produced data when resuming logging and documents the critical fix.
    [ESP32_S3.ino]
2026-06-13 Adjust SD remaining-hours calculation
    Update the remaining-hours estimate to reflect the new data rate/format by changing the divisor from 20.16 to 11.88 (matches the optimized 33-byte packed frame architecture at 100Hz). Also keep the 64-bit cast for cluster arithmetic to avoid overflow on large SD cards and add an explanatory inline comment.
    [ESP32_S3.ino]
2026-06-13 Yield to watchdog during SD flush; clarify SD calc
    Remove unused lastPrintMillis variable. Add a flushCount and periodic vTaskDelay during dataQueue flushing so the RTOS Task Watchdog is fed every 500 frames, preventing hard resets when emptying large PSRAM-backed buffers to SD. Clarify SD free/remaining capacity calculations and document the dynamic bandwidth assumption (33 bytes * 100 Hz = 11.88 MB/hour). Minor comment and spacing adjustments.
    [ESP32_S3.ino]
2026-06-13 Purge dataQueue on log start and after wipe
    Call xQueueReset(dataQueue) in loggingTask when creating a new log file and after clearing all logs. This critical fix clears stale sensor frames that may accumulate during menu interactions or formatting, ensuring new recordings start from a clean buffer and preventing leaked frames from being written to new sessions. Also includes small comment/formatting tweaks around the reset logic.
    [ESP32_S3.ino]
2026-06-13 Rewrite To Do list with structured sections
    Rework the DeadReckoner To Do list: cleaned up formatting, reorganized and consolidated items into clear sections (Core Data Logging & Architecture, UI/UX, MATLAB/Post‑processing, Hardware). Updated and checked completed tasks (SD dynamic recovery, PSRAM buffering, frame size reduction, gap frames, queue fixes, pin relocations, MATLAB stitcher, safe shutdown, etc.), added concrete hardware recommendations (decoupling caps, I2C pullups, button debouncing), and clarified outstanding action items (MPU9250 health tracking, GPS integration, BMP280, watch‑dog evaluation, ZUPT/SHS/LSTM research). Removed older unstructured entries and improved readabi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
2026-06-14 Add AI-generated code review report
    Add Report/Issues found by AI.md containing a comprehensive AI review of the ESP32-S3 DeadReckoner firmware. The document consolidates findings from multiple reviewers (deep seek, ChatGPT, Claude), enumerates critical/major/minor issues (thread-safety, SD recovery, timing, data integrity, UI and power handling), provides recommended fixes and improvements, and includes overall scores. This file is intended to guide remediation and prioritize reliability and performance fixes.
2026-06-14 Add bandwidth metrics, PSRAM sizing & IMU temp
    Introduce a parametric bandwidth/memory engine (DATA_FRAME_SIZE, SAMPLING_RATE_HZ, BYTES_PER_SECOND, BYTES_PER_HOUR, MB_PER_HOUR, QUEUE_LENGTH, PSRAM_BUFFER_SIZE_MB) to compute PSRAM buffer sizing and dynamic bandwidth. Add imu.temp to LogFrame, populate it in sensorTask, and display the stored temperature on the OLED (use receivedFrame.payload.imu.temp instead of calling mpu.getTemperature() directly). Replace the hardcoded 11.88 MB/hr with MB_PER_HOUR when estimating remaining SD hours, move/clean up the QUEUE_LENGTH definition, and print the computed PSRAM buffer size at setup. Update struct size/comments and perform minor formatting/whitespa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
    [ESP32_S3.ino]
2026-06-14 Move OLED auto-off and trigger force UI update
    Relocates the OLED auto-off power management check in loggingTask from before the graphics rendering phase to after rendering completes. When the timeout is hit the code now sets power save, updates currentState, and sets force_update_ui = true to ensure the UI state is refreshed when entering sleep. Also includes a tiny whitespace cleanup in setup().
2026-06-14 Add calibration prototypes and reorder globals
    Move and consolidate several preprocessor defines and global declarations for clarity, add forward declarations for calibration functions (performCalibration, print_calibration, saveCalibration, loadCalibration) to avoid scope issues, and reorder UI/menu-related globals (MENU_ITEMS_COUNT, menuItems, menuCursor, subMenuMsg) and log filename. Also cleaned up spacing/indentation and removed duplicated QUEUE_LENGTH define. No functional logic changes intended—just reorganization and preparatory prototypes.
    [ESP32_S3.ino]
2026-06-14 Add spinlocks for frame counter and tag events
    Introduce two portMUX_TYPE spinlocks (frameCounterMux, tagEventMux) and use portENTER_CRITICAL/portEXIT_CRITICAL around accesses to global_frame_counter and tag_event_triggered. Protects incrementing/initializing the frame sequence and setting/clearing the waypoint tag flag across cores (sensorTask and loggingTask) to prevent race conditions and inconsistent frame_seq or tag events on ESP32-S3 multicore operation. Comments added to clarify intent.
    [ESP32_S3.ino]
2026-06-14 Initialize SD gap LogFrame before write
    Fix SD recovery gap frame initialization to avoid writing garbage bytes. Previously the gap frame used 0xFFFFFFFF and left payload/identifiers uninitialized. Now the commit sets frame_seq to global_frame_counter, marks event_flag as 0xAA to identify the SD_GAP event, clears the IMU payload fields with memset, and forces a synced write to ensure a sterile gap marker and improve log integrity during SD recovery.
    [ESP32_S3.ino]
2026-06-14 Add EEPROM sentinel and robust calibration load/save
    Introduce an EEPROM magic sentinel (EEPROM_MAGIC_NUMBER / EEPROM_MAGIC_ADDR) and reserve space for it. saveCalibration() now writes the magic before calibration floats and loadCalibration() validates the magic first; if missing, it logs a warning, applies factory defaults (zero biases, unit scales) and aborts loading to avoid reading corrupt floats. Adjusts address offsets accordingly and adds a calibration header comment. This improves robustness of calibration persistence across reboots.
    [ESP32_S3.ino]
2026-06-14 Add timestamp to LogFrame and update frame size
    Increase DATA_FRAME_SIZE to 41 and add a uint32_t timestamp to the packed LogFrame to capture a high-precision microsecond hardware timestamp. Populate frame.timestamp in sensorTask (using esp_timer_get_time()) and for SD gap frames in loggingTask, and ensure gap frames' payloads are zeroed to avoid garbage. Update display logic to compute runtime from the hardware timestamp (microseconds -> seconds) instead of frame_seq. Small comment and struct documentation updates to reflect the new parametric binary layout.
    [ESP32_S3.ino]
2026-06-14 Improve SD space calc and file counting
    Prevent arithmetic overflow for large SD cards by casting cluster calculations to uint64_t and compute sd_total_gb. Replace slow brute-force sd.exists() loop with a high-speed directory iteration (openNext) that filters for ".BIN" files and counts only files starting with "DR_LOG_". Add safer buffer sizes, explicit file/root closes, and ensure SD-related globals are zeroed in the fallback branch. These changes improve performance and correctness when scanning large cards and many log files.
    [ESP32_S3.ino]
2026-06-14 Increment recovery ID after SD file open
    Fixes Issue #9: generate the recovery filename from the current validated indices and only increment global_recovery_id after the SD file is successfully opened. Previously the index was incremented before verifying the file open, which could lead to skipped or mismatched filenames on failure. Also updates comments and cleans up minor whitespace.
    [ESP32_S3.ino]
2026-06-14 Fix runtime display and EEPROM offset
    Compute displayed runtime from receivedFrame.timestamp (microseconds) instead of deriving seconds from frame_seq, ensuring the on-screen T: value reflects real elapsed time. Also fix EEPROM calibration storage by starting writes after the 16-bit magic (addr = sizeof(uint16_t)) and consolidating addr increments so each float is stored at the correct offset, preventing overlap with the magic value.
    [ESP32_S3.ino]
2026-06-14 Zero-initialize gap LogFrame before SD write
    When recovering the SD card, fully clear the LogFrame used as a gap marker to eliminate any uninitialized/garbage bytes. Replace selective payload memsets with a single memset(&gapFrame, 0, sizeof(LogFrame)) and then assign frame_seq, timestamp and event_flag before writing the sterile block to the log file. This ensures consistent, deterministic gap records during SD recovery.
    [ESP32_S3.ino]
2026-06-14 Validate log file after MPU recovery
    After recovering the MPU, validate the reopened log file and set sd_critical_error if the file pointer is invalid to avoid silent write failures (addresses FIX ISSUE 5). Also make minor loggingTask cleanup: ensure periodic sync sets sd_critical_error on failure and adjust closing braces/formatting for the loggingTask function.
    [ESP32_S3.ino]
2026-06-14 Remove unused SD recovery timer variable
    Delete the unused `last_sd_recovery_attempt` variable from sensorTask in ESP32_S3.ino. This cleans up an unnecessary local variable, avoiding potential compiler warnings and slightly reducing memory usage while keeping existing MPU recovery logic intact.
    [ESP32_S3.ino]
2026-06-14 Add configureMPUSettings helper
    Introduce configureMPUSettings(MPU9250Setting&) to centralize MPU9250 setting assignments (accel/gyro/mag/fifo/filter). Replace duplicated manual initialization in setup() and attemptMPURecovery() with the new helper to reduce code duplication and improve maintainability; no functional behavior changes.
    [ESP32_S3.ino]
2026-06-14 Support recovery logs and use vTaskDelay
    Detect recovery-style .BIN files (exactly 10 chars with first 6 digits) in addition to existing DR_LOG_ parent sessions and include them in totalFilesCount. Replace blocking delay() calls with FreeRTOS vTaskDelay(pdMS_TO_TICKS(...)) for the buzzer and the "All Logs Cleared!" pause to avoid blocking the logging task and potential watchdog starvation.
    [ESP32_S3.ino]
2026-06-14 Remove unused STATE_SUBMENU_MSG and handlers
    Delete the deprecated STATE_SUBMENU_MSG enum value and remove its navigation and rendering code in Code_deadreckoner/ESP32_S3/ESP32_S3.ino. This cleans up the UI state machine by eliminating an unused message submenu, removing the select/back handling and the drawStr rendering block, and simplifies conditional branches with no intended functional changes.
2026-06-14 Safely wipe logs: suspend sensor, purge SD
    During SD wipe confirmation the sensor task is now suspended/resumed to avoid concurrent access. The delete loop was enhanced to remove parent logs and orphaned recovery fragments, and a short vTaskDelay is added each iteration to feed the watchdog. After wiping the code resets current_log_filename, global_log_id, global_recovery_id and zeroes global_frame_counter inside a critical section, resets the data queue, reopens a fresh log file, and updates the UI. These changes prevent race conditions, watchdog resets, and stale frames leaking into the new session.
    [ESP32_S3.ino]
2026-06-14 Expand data frame & add O(1) log naming
    Increase DATA_FRAME_SIZE from 41 to 45 and change frame timestamp from uint32_t to uint64_t to prevent the ~71-minute esp_timer overflow; corresponding timestamp assignments removed 32-bit casts. Add max_log_id to track the highest DR_LOG index and replace the sd.exists scanning loop with an O(1) instantaneous file creation path (increments max_log_id, capped at 999). Ensure new-file creation resets global_frame_counter under mutex and purges the dataQueue so new logs start from a sterile buffer. Initialize max_log_id in setup and apply small formatting/comment clarifications.
    [ESP32_S3.ino]
2026-06-14 Make frame sequence counter thread-safe
    Clear the LogFrame structure and protect capture/increment of global_frame_counter with a critical section (portENTER_CRITICAL/portEXIT_CRITICAL). This ensures the frame_seq is assigned atomically and monotonically to avoid race conditions and uninitialized/garbage bytes in the frame.
    [ESP32_S3.ino]
2026-06-14 Track dropped frames and fix SD menu/UI
    Add dropped_frames_count to global state and increment it when xQueueSend fails, providing LED_RED feedback on silent queue overflows to help diagnose missed frames. Zero-initialize gapFrame with memset before populating and perform global_frame_counter updates inside the frameCounterMux critical section to avoid uninitialized data and race conditions. Update SD submenu UI: expand the lines buffer, add a "Drops" entry, shift menu indices, and handle the new SD menu cursor case to return to the main menu. Misc: minor comment cleanup.
    [ESP32_S3.ino]
2026-06-14 Expand SD menu to 8 items and fix actions
    Add an 8th item to the SD submenu and correct navigation and action mappings to avoid off-by-one/select bugs. Adjust sdMenuCursor bounds (0..7) and remap SELECT behavior so the new "Drops" entry jumps to Live View; shift Create/Format/Back handling to the correct indices and default confirmation focus to NO for safety. Add a null-check after dynamic log file creation to set sd_critical_error on failure. Improve robustness during full card wipe: suspend the sensor task while wiping, insert small vTaskDelay yields to avoid WDT timeouts, reset max_log_id after format, reset the data queue, and reopen the initial log file. Minor whitespace/cleanup change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
    [ESP32_S3.ino]
2026-06-14 Improve SD recovery and new log file creation
    Disable hardware alarms (LED/buzzer) before calling blocking SD recovery to prevent continuous buzzer output. Ensure thread-safe capture and monotonic increment of the frame sequence counter and capture a 64-bit microsecond timestamp. After successful recovery, explicitly clear/reset hardware signals and provide user feedback. When creating a new log file, sync and close the previous file, safely bump the max_log_id to guarantee a new filename, reset recovery and frame counters within a critical section, and null-check the opened file to set a critical error if creation fails. Added clarifying comments and minor cleanup.
    [ESP32_S3.ino]
2026-06-15 Relative timestamps, OLED reinit, buzzer beeps
    Introduce log_time_base (uint64_t) and record frame.timestamp as esp_timer_get_time() - log_time_base so timestamps are relative to the current log. Initialize log_time_base at initial boot and whenever the frame/ log counters are reset (inside critical sections). Add a two-beep audible pattern when entering the safety/green-LED state. Improve OLED resilience by calling u8g2.begin(), setFont() and setPowerSave(0) on wake and when entering the menu, and force a UI update to avoid stale displays. These changes improve timestamp consistency across log files and recoverability of the display/hardware feedback after hot-plug or power events.
    [ESP32_S3.ino]
2026-06-15 Fix timing, SD math, and logging robustness
    Address multiple stability and correctness issues:
    - Remove unused subMenuMsg variable.
    - Prevent 64-bit torn reads across cores by atomically copying shared log_time_base into a local uint64_t inside a critical section and use that for timestamp calculation. This ensures high-precision esp_timer timestamps are computed relative to a consistent time base.
    - Zero-initialize receivedFrame to avoid rendering garbage stack bytes before the first frame arrives.
    - Use 64-bit casts when calculating free/total MB from cluster counts to avoid overflow on large SD cards (>32GB) and update related comments.
    - Update bandwidth accounting comment to reflect 45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
    [ESP32_S3.ino]
2026-06-15 Update Progress.md with storage, recovery, UI
    Expand the project progress report to document extensive storage, logging, recovery, UI, and analysis improvements. Adds detailed binary LogFrame design (packed/union payloads), 64-bit timestamps, PSRAM-backed buffering and queue architecture, deterministic file naming, gap-frame markers, frame sequencing and dropped-frame accounting, SD recovery/fragment logging and write verification, watchdog-safe shutdowns, and FAT/performance fixes. Also documents UI/monitoring enhancements (OLED menus, storage dashboard, runtime recovery feedback, log management), a new Phase 8.5 (memory optimization & scalability), data-analysis toolchain updates (fragment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
2026-06-15 Merge Report.md (v1.0.0) into Report2.md (v2.0.0); promote v2.0.0 as main
    - Enriched Hardware Inventory §1 with component descriptions
    - Added 3-point ESP8266->ESP32-S3 migration rationale to §3
    - Expanded Multi-Core §7 with race condition details and LogFrame code
    - Restored numeric test results (0.43deg drift, 0.07deg RTZ, 0.57deg vibration) to §8
    - Added SPI sweep table (1-26 MHz) and bandwidth calculations to §9
    - Added pinout table, Challenges & Solutions, Phase 4 summary to §10
    - Detailed 8-item SD Manager scrolling menu and confirmation traps in §11
    - Documented SOS alarm, dynamic SD recovery, I2C timeout in §12
    - Expanded timeline from 11 to 42 entries covering all important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
    [Mission_001.csv]
2026-06-17 Update Report.md from project_report.md: add project_summarizer.py to Phase 9, expand timeline with 16 missing entries
    Based on Repo_Report/project_report.md (auto-generated project analysis):
    Phase 9 additions:
    - Added Project Documentation Generator entry for project_summarizer.py
    (1216 lines, 26 functions, outputs MD/TXT/XML reports with full git
    history, directory tree, and source signature analysis)
    Timeline expansion (16 new entries):
    - 2026-06-12: AI code review report (Issues found by AI.md)
    - 2026-06-14: Expand data frame & O(1) naming (45-byte LogFrame, max_log_id)
    - 2026-06-14: Thread-safe frame counter (portMUX_TYPE critical sections)
    - 2026-06-14: Dropped frame tracking (r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
2026-06-17 Add NEO-6M GPS diagnostic Arduino sketch
    Add GY-GPS6Mv2.ino: an Arduino Uno (ATmega328P) diagnostic/validation sketch for NEO-6M (GY-GPS6Mv2) using SoftwareSerial and TinyGPSPlus. Initializes Serial at 115200 and SoftwareSerial on pins 2(RX)/3(TX) at 9600 baud, streams live GPS data, and prints satellite count, latitude, longitude, altitude, speed, and time. Includes wiring notes, cold-start/antenna reminders, and a hardware timeout that alerts if no GPS data is received within ~5s (charsProcessed < 10).
2026-06-19 Mark resolved issues and add notes in reports
    Update Report/Issues found by AI.md and Report/To Do list.md: mark MPU temperature read and recovery file naming items as resolved and add explanatory notes (FIXED / INTENTIONAL). Update the legend to indicate `[x]` = resolved in ESP32_S3.ino v1.9. Mark SD card inrush capacitor item as resolved in the To Do list and perform minor formatting/whitespace cleanup.
2026-06-19 Report: mark delay and CRC issues fixed
    Update Report/Issues found by AI.md to reflect implemented fixes: mark `delay()` usage as partially addressed (calibration `delay()` calls replaced with `vTaskDelay()` at lines 1348, 1354, 1393; setup delays remain pre-RTOS) and mark CRC/checksum per frame as added. Notes that a CRC-16-IBM (poly 0xA001) `uint16_t crc` field was added to `LogFrame`, computed before each `xQueueSend` in `sensorTask` and for gap-frame SD writes in `loggingTask`, and `DATA_FRAME_SIZE` was updated from 45 to 47.
2026-06-19 Add CRC to log frames and use RTOS delays
    Introduce a 16-bit CRC into LogFrame for on-disk/frame integrity and update DATA_FRAME_SIZE accordingly (45 -> 47). Add calcCRC16() implementation and compute/set CRC when frames are produced (sensorTask) and when writing gap markers (loggingTask). Replace blocking delay() calls with vTaskDelay(pdMS_TO_TICKS()) for proper FreeRTOS behavior during calibration and status display. Minor struct/comment cleanup to reflect the new frame layout.
    [ESP32_S3.ino]
2026-06-19 Report: add CRC-16 frames & offline PDR pipeline
    Update project report and TODOs to document per-frame CRC and a shift to an offline Pedestrian Dead Reckoning (PDR) pipeline. Bumped version/date and renamed report header; LogFrame expanded from 45→47 bytes to include a 2-byte CRC-16-IBM (poly 0xA001) computed before queue send and SD writes. Phase 10 was rewritten into a Python-based PDR pipeline (binary parsing + CRC verification, world-frame rotation, step detection, Weinberg step length, heading from quaternions, ZUPT/RTS smoothing, visualization). Timeline and status tables updated (perfboard assembly, CRC addition, vTaskDelay conversion), and the To Do list now enumerates the PDR impl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
2026-06-19 fix 100Hz sensor loop and Gap frame timestamp
    Use vTaskDelayUntil in sensorTask with a 10ms period (initialize xLastWakeTime) to enforce a stable 100Hz sampling loop and remove the ad-hoc vTaskDelay yield. In loggingTask, capture log_time_base inside the critical section alongside the frame sequence, and make gapFrame.timestamp relative to that time base (esp_timer_get_time() - local_time_base) so gap/frame timestamps are consistent with IMU frames. These changes improve timing determinism and timestamp alignment between sensor and logging code.
    [ESP32_S3.ino]
2026-06-19 fix 3: Don't reset last_interaction_millis on UP/DOWN if SELECT is being held
    Prevent the inactivity timestamp from being reset while the select button is held. The change conditions the update of last_interaction_millis on !selectWasPressed in the tag, up, and down button handlers in Code_deadreckoner/ESP32_S3/ESP32_S3.ino so holding select won't mask other interactions or continually reset the inactivity timer.
    [ESP32_S3.ino]
2026-06-19 fix 4: Increase SensorTask stack size to 8KB
    Raise the sensorTask stack allocation from 4096 to 8192 bytes to provide more headroom for larger local data or deeper call stacks and reduce risk of stack overflows. Task remains pinned to core 0 with the same priority and handle usage unchanged.
    [ESP32_S3.ino]
2026-06-19 fix 5: Increase WDT yields in loggingTask (WDT risk during Format)
    Adjust vTaskDelay timings in loggingTask to better feed the watchdog during long operations. The inner recovery-file-delete yield was increased from 1ms to 2ms and the parent-iteration baseline yield was increased from 1ms to 3ms; accompanying comments were updated to reflect the intent to yield for WDT servicing.
    [ESP32_S3.ino]
2026-06-19 fix 6: Add CRC check for EEPROM calibration data
    Compute and store a 16-bit CRC when saving calibration values and verify it when loading. The saver computes CRC over the first 46 bytes (magic + calibration floats) and writes the uint16_t CRC at EEPROM offset 46 before committing. The loader reads the stored CRC, recomputes the CRC over the same 46 bytes, and if it doesn't match logs a warning, resets sensor biases/scales to safe defaults and aborts loading to protect the Madgwick filter from corrupt floats. Uses calcCRC16 to perform the checksum.
    [ESP32_S3.ino]
2026-06-19 fix 6-1: Notify on invalid calibration with LED and buzzer
    Add visual and audible alerts when calibration data is missing or CRC-check fails. The code now displays a brief message on the u8g2 OLED, pulses LED_RED_PIN and emits two buzzer beeps (using ALARM_BEEP_MS) before falling back to factory bias defaults. This improves user feedback for EEPROM calibration errors while preserving existing fallback behavior.
    [ESP32_S3.ino]
2026-06-19 fix 7: Add short delay after SPI.end before reinit
    In attemptSDRecovery(), insert a 10 ms vTaskDelay after SPI.end() to allow the SPI hardware to power-cycle before calling SPI.begin()/sd.begin(). This reduces race conditions when reinitializing the SD SPI interface after closing the log file.
    [ESP32_S3.ino]
2026-06-19 Update report & AI issues to v2.0
    Bump references to version 2.0 and update project report timeline. Issues found by AI.md now notes fixes resolved in ESP32_S3.ino v2.0. Report.md timeline was revised to include several v2.0 changes and fixes including CRC-16 per-frame integrity, gap-frame relative timestamps, strict 100 Hz sampling (vTaskDelayUntil), tag/select interaction guard, doubled sensorTask stack, WDT-safe format yields, EEPROM CRC-16 validation, SPI recovery power-cycle delay, and miscellaneous version/comment cleanups.
2026-06-20 Add Garmin and GeoTracker GPX tracks for walk1
    Add two GPX exports for 2026-06-20/walk1: Code_deadreckoner/Python/GPXFusion/data/2026-06-20/walk1/Garmin.gpx (Garmin Desktop App export with metadata, bounds and ~511 m track) and Code_deadreckoner/Python/GPXFusion/data/2026-06-20/walk1/GeoTracker.gpx (Geo Tracker Android export with detailed track points, extensions and reported length ~514.23 m). These raw GPX files provide source GPS data for GPXFusion processing and analysis.
2026-06-20 Add GPX Fusion GUI and requirements
    Introduce a new PyQt6-based GPX Fusion application (fusion_ui.py) that parses Garmin and Geo Tracker GPX logs, fuses tracks using a Kalman filter with optional RTS smoothing, and renders maps (matplotlib offline and folium online). Features include GPX import, per-walk grouping, device-specific noise handling, interpolation to a common time grid, map preview, proxy settings, and exporting fused GPX. Also add a requirements.txt listing the Python dependencies. (Includes compiled bytecode in __pycache__.)
2026-06-20 Improve UI, map rendering, and WebEngine handling
    Remove stale __pycache__ file and apply multiple UI and map fixes: set QT env vars to avoid Compositor errors; add QCoreApplication import and minor style tweaks for widgets and buttons; update matplotlib map rendering with explicit white facecolor, axis colors and a zoom_factor parameter; add zoom controls and persist zoom_level when generating maps. Fix folium/QtWebEngine flow by unparenting the QWebEngineView before setHtml, connecting loadFinished, deferring parenting until after content loads, and running JS to force map sizing/invalidateSize. Correct HTTPS/proxy request handling by attaching an HTTPSHandler with an SSL context and build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
2026-06-20 Document GPX Fusion Tool (PyQt6)
    Add documentation for the new GPX Fusion Tool across README and reports. README now lists the GPXFusion app, example file layout (Code_deadreckoner/Python/GPXFusion/), usage notes, and offline/online map modes. Report/Progress.md and Report/Report.md include a completed Phase 12 entry detailing features (GPX parser, Kalman filter + RTS smoother, 1 Hz interpolation, matplotlib offline map, folium online map, proxy dialog, file/group management, export, UI/behavior fixes). Report changelog updated with GPX Fusion entries and To Do list extended with remaining UI/resize/export tasks.
2026-06-20 Add BMP280 diagnostic sketch and results
    Introduce a standalone Arduino diagnostic suite for the BMP280 barometric sensor (BMP280_Diagnostic.ino). The sketch performs I2C init, chip ID verification, temperature/pressure sanity checks, I2C bus scan, configuration register dump, mode/oversampling sweep and a 100-sample noise-floor measurement. Notes wiring and requires Adafruit_BMP280 library. Also add a sample run output file (Result_Diagnostic_BMP280.txt).
    [BMP280_Diagnostic.ino]
2026-06-20 Fix degree symbol and SD label in BMP280 diagnostic
    Replace incorrect escape sequence \x30C with correct degree symbol \xB0C in BMP280_Diagnostic.ino, and change sigma escape \xE3 to "SD" for standard deviation. Also update Result_Diagnostic_BMP280.txt with new temperature/pressure sample values and revised statistic labels to match the code output. Improves serial output readability and corrects symbol rendering.
    [BMP280_Diagnostic.ino]
2026-06-20 Add BMP280 5-min drift & altitude test
    Add an Arduino sketch (BMP280_DriftTest.ino) that performs a 300 s, 1 Hz drift and altitude validation for the BMP280 sensor using Adafruit_BMP280. The sketch logs time, temperature, pressure and calculated altitude in CSV, computes min/max/mean/SD for each channel, computes trend slopes from the first/last 30 s, and performs an altitude check against a configurable REFERENCE_ALTITUDE_M (and SEALEVEL_PRESSURE_HPA). Wiring notes and sensor configuration (I2C addr, oversampling, chip ID check) are included. Also add a Result_BMP280_DriftTest.txt file containing a sample run output and summary.
    [BMP280_DriftTest.ino]
2026-06-20 Apply pressure offset and harden variance calc
    Introduce a P_OFFSET (800 hPa) and subtract it from each pressure sample before accumulating sums to avoid loss of precision when computing noise statistics. Compute mean pressure by re-adding the offset, and calculate temperature/pressure variances with a safety clamp (tVar/pVar < 0 -> 0) before taking the square root to prevent NaNs from tiny negative rounding errors. Minor local refactoring: use pOff for summed/variance terms while leaving raw p for min/max checks.
    [BMP280_Diagnostic.ino]
2026-06-20 Document BMP280 and GY-GPS6Mv2 validation
    Add sensor validation results and test artifacts to project reports: Progress.md gains Phase 11 (GY-GPS6Mv2/NEO-6M) with three completed Arduino sketches (Live Diagnostic Monitor, ColdStart & re-acquisition, 1‑Hour Static Precision) and their test behaviors (TTFF, HDOP/sats, CEP, CSV output, non-blocking diagnostics). Report.md updated with BMP280 validation summary and changelog entries for BMP280 and GY-GPS6Mv2 tests (BMP280 5‑min drift: σT=0.07 °C, σP=0.08 hPa, altitude σ=0.00 m; diagnostic compile ~53% flash/26% SRAM). To Do list updated to mark BMP280 evaluation as complete and ready for integration. These edits record completed hardware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
2026-06-20 Add NEO-6M cold-start test sketch and results
    Add an Arduino test harness (GPS_ColdStart.ino) for the NEO-6M (GY-GPS6Mv2) that measures cold-start TTFF, logs a 120s stabilisation period (satellites, HDOP, lat/lon/alt, age) and runs a re-acquisition (power-cycle) timing test. The sketch uses SoftwareSerial (pins 2 RX / 3 TX) at 9600 baud and prints a final summary with fix statistics and position stability estimates. Also add Result_GPS_ColdStart.txt containing a sample run output (per-sample logs and final summary). Sketch includes wiring notes, test sequence and author/date comments.
    [GPS_ColdStart.ino]
2026-06-20 Enhance GY-GPS6Mv2 diagnostic tool + results
    Remove the old, minimal GY-GPS6Mv2 sketch and add an improved diagnostic sketch plus a sample output log. The new sketch (moved into a nested folder) adds: heartbeat/status messages, time-to-first-fix (TTFF), stale/fix tracking, HDOP and satellite statistics (min/avg/max), periodic 5‑minute summaries, formatted live output (SATS/QLT/HDOP/LAT/LNG/ALT/SPEED/TIME), and a wiring/usage header. Also includes Result_GY-GPS6Mv2.ino.txt containing a recorded run of the tool. This change provides more robust hardware validation and visibility into GPS performance.
    [GY-GPS6Mv2.ino]
2026-06-20 fix 1: Change gyro DLPF, reset queue, fix cal CRC size
    Adjust MPU9250 gyroscope DLPF cutoff from DLPF_5HZ to DLPF_41HZ. In loggingTask, reset the data queue (xQueueReset) to purge old frames so stale data won't be written into new log files. Update calibration CRC handling: expand the CRC range from 46 to 50 bytes and store/read the CRC at offset 50 to cover the full calibration block before committing to EEPROM.
    [ESP32_S3.ino]
2026-06-20 Validate SAMPLING_RATE_HZ and apply to sensor task
    Add a compile-time check ensuring SAMPLING_RATE_HZ is between 1 and 1000 to avoid exceeding MPU9250 FIFO limits. Replace the hardcoded 10ms vTaskDelayUntil with pdMS_TO_TICKS(1000 / SAMPLING_RATE_HZ) so the sensorTask uses the configured sampling rate. Update MPU9250 configuration comments to clarify that FIFO sample rate must be >= SAMPLING_RATE_HZ and that DLPF cutoffs should respect Nyquist (<= SAMPLING_RATE_HZ/2), plus other minor documentation cleanups.
    [ESP32_S3.ino]
2026-06-20 fix 4: Zero-initialize LogFrame locals
    Value-initialize LogFrame variables in sensorTask and loggingTask (use LogFrame frame = {} and LogFrame flushFrame = {}) to avoid uninitialized/garbage data and potential undefined behavior when reading or flushing frames. This ensures deterministic initial state for stack-allocated LogFrame instances.
    [ESP32_S3.ino]
2026-06-20 Add device info and OLED hot-plug comments
    Update file header metadata (date, version -> 2.1) and Reason for Last Edit to reflect recent work. Add DEVICE line specifying ESP32-S3 N16R3 and note PSRAM/SD conflict and other bookkeeping items. Expand comments in loggingTask to document OLED hot-plug behavior and why u8g2.begin()/setPowerSave calls are required to recover a physically reconnected I2C display. Changes are primarily documentation/comment updates and do not alter runtime logic.
2026-06-20 Add file header to binary logs and parser support
    Introduce a 16-byte FileHeader written to each DR_LOG_*.BIN (magic 0xDEADC0DE, version, frame_size, sample_rate, epoch_ms) and a writeLogFileHeader(File&) helper. Write the header when creating/opening log files (setup, loggingTask paths and after clearing logs) to make files self-describing and time-anchored. Update the Matlab/Python parser: bump version to 2.0, adjust FRAME_SIZE to 47, detect and skip the new 16-byte header for backward compatibility, and update IMU_FMT/unpacking to account for the added CRC field. This enables forward-compatible parsing and reliable file identification while preserving legacy file handling.
    [ESP32_S3.ino]
2026-06-20 Add null checks and calibration gap frame
    Add safety checks when querying the SD card (ensure sd.card() and sd.vol() are valid before checking errorCode) to avoid null dereferences. Also write a special gap LogFrame (event_flag = 0xAA) into the data queue after saving calibration to mark the calibration boundary in logs; the frame sets frame_seq, timestamp and crc and is sent while the sensor task is suspended to avoid races.
    [ESP32_S3.ino]
2026-06-20 Docs: update to v2.1, N16R3, and issue fixes
    Update documentation to reflect v2.1 changes: README board revision changed to ESP32-S3 N16R3; mark and document multiple fixes in Report/Issues found by AI.md (CRC-16, FileHeader support, sampling-rate wiring, gap frames after calibration, sd.card() null-check, zero-init LogFrame, OLED rationale, WDT/yield fixes, DLPF change, EEPROM CRC address, LED recovery clearing, SPI/PSRAM note, etc.); add v2.1 entry and date bump (2026-06-20) in Report/Report.md and Progress.md; mark binary parser task complete in To Do list with FileHeader support. These edits consolidate the v2.1 bugfixes and cleanup into project reports.
2026-06-20 Use counter for tag events (uint8_t)
    Replace the boolean tag_event_triggered flag with a volatile uint8_t tag_event_pending counter to capture consecutive TAG presses. Update sensorTask to check tag_event_pending and decrement it inside the tagEventMux critical section, and update loggingTask to increment the counter (capped at 255) inside the same critical section. This prevents missed rapid button presses and avoids overflow while preserving thread-safe inter-core signaling.
    [ESP32_S3.ino]
2026-06-20 Bump report to v2.2 and document TAG fix
    Update report files to reflect v2.2 changes: bump Report.md version to 2.2.0 and add a v2.2 changelog entry describing the TAG button fix. In Report/Issues found by AI.md mark the "Consecutive TAG button presses lost" item as fixed and add details: changed volatile bool -> volatile uint8_t (tag_event_pending) counter, capped at 255, logger increments per press and sensor decrements per frame so each press yields its own event_flag=1 frame. Also apply editorial updates (strikethroughs and explanatory notes) to several checklist items to indicate they are considered non-issues or feature requests rather than bugs. These changes update release notes and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
2026-06-20 Add collected GPS and DR logs (2026-06-20)
    Add device-collected data for 2026-06-20: five Garmin GPX tracks, five GeoTracker GPX tracks, and five deadreckoner binary logs (DR_LOG_001..005) under Collectd Data/2026-20-6. Files contain recorded track segments, timestamps and metadata for mapping/analysis and archival.
2026-06-20 Add PDR vs GPS comparison tool and plots
    Add compare_paths.py — a DeadReckoner path comparison tool that parses 45-byte BIN logs, computes IMU-based PDR (Weinberg step length + quaternion heading), parses GPX references (Garmin & GeoTracker), auto-aligns headings, computes per-segment metrics, and produces interactive and batch plots. Includes analysis output images (analysis/summary_comparison.png and analysis/all_segments_overlay.png). Usage: run interactively or with --batch to save figures; intended for 5 simultaneous walk segments and depends on numpy, scipy and matplotlib.
2026-06-20 Add WiFi AP phone GPS pairing and GPS frames
    Introduce phone-based GPS start/end anchoring via a WiFi soft-AP and captive portal. Resolves FS.h / SdFat File name conflict (temporary File macro rename) and redefines FILE_WRITE for SdFat. Adds AP configuration, DNS captive-portal, embedded HTML form, and WebServer handlers (/ and /gps) to accept lat/lon/alt/time JSON from a phone. Implements startGPSAP/stopGPSAP, GPS HTTP handlers, writeGPSFrame(), and a PhoneGPSData struct.
    Integrates GPS pairing into the logging/UI flow: new UI states for GPS prompts (start/end/wait/confirm), defers file creation when a GPS start is requested so a 0xBB start-frame can be written when pairing completes, and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
    [ESP32_S3.ino]
2026-06-20 Add DR_LOG_001 binary, parser and parsed output
    Add raw log DR_LOG_001.BIN, a human-readable Result.txt produced by the parser, and parse_log.py which parses the binary log. The parser expects a 16-byte file header (magic 0xDEADC0DE, version, frame_size, sample_rate, epoch_ms) and 47-byte log frames (seq, timestamp, event_flag, 32B payload, crc). It decodes IMU and GPS payloads, prints file/header/frame stats, first/last IMU samples, GPS frames, event breakdown and integrity checks (sequence gaps). Result.txt is the sample output for DR_LOG_001.BIN (file size ~547 KB, 11,642 frames, 11,640 IMU frames, 2 GPS frames, 3 sequence gaps). parse_log.py currently uses a hardcoded LOG_PATH; consider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
2026-06-20 Update reports: PDR verification, GPS fixes, N16R8
    Update project documentation to reflect firmware v2.2 changes and board rev N16R8. Files updated: Report/Issues found by AI.md (added Bug Fixes & Technical Debt section with GPS bug fixes: JSON parseFloat, writeGPSFrame storing alt/epoch, OLED sleep exceptions, SdFat/FS.h File macro workaround, clearing stale GPS state), Report/Progress.md (mark PDR and Phone GPS pairing completed, add compare_paths.py summary and verification results), Report/Report.md (note board revision N16R8, expand LogFrame GPS payload to include alt and epoch, add PDR vs GPS accuracy table and key v2.2 achievements), and Report/To Do list.md (mark WiFi GPS pairing and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
    [ESP32_S3.ino]
2026-06-21 Add DeadReckoner logs and GeoTracker GPX data for 2026-21-6-6AM
    Add collected sensor data for Jun 21, 2026 6:28 AM: DeadReckoner binary logs (001001.BIN, DR_LOG_001.BIN–DR_LOG_005.BIN) and GeoTracker GPX tracks (1.gpx–5.gpx) under Collectd Data/2026-21-6-6AM. The GPX contains full track points and metadata (creation time, length, duration) for the recorded activity.
2026-06-21 Switch MPU9250 filter algorithm to MAHONY
    Change MPU9250_filter_algorithm from MADGWICK to MAHONY in ESP32_S3.ino. This updates the selected sensor fusion algorithm used for IMU data processing; other related settings (filter iterations, DLPF choices) remain unchanged. Adjust if different fusion behavior or performance is required.
2026-06-21 Add PDR analysis docs, scripts, and plots
    Add complete analysis artifacts for the 2026-21-6-6AM dataset: ANALYSIS_METHODS.md (methods, diagnosis, and firmware fix), compare_paths.py (47-byte BIN parser, CRC16 matching firmware, PDR pipeline, GPS-guided mode and path similarity metrics), tune_pdr.py (Weinberg K tuning), per-segment Result 1 report, and numerous diagnostic and comparison plots. These files capture the investigation, fixes (CRC/frame layout and tune_pdr lat/lon bug), and visualization outputs for the PDR vs GPS study.
2026-06-21 Update report: PDR tuning, bug fixes, Mahony switch
    Update project report and TODOs to reflect PDR analysis fixes and firmware change. Fixes include a bug in tune_pdr.py (passing local xy vs lat/lon), discovery of optimal Weinberg K=0.425 (height=1.5, dist=25) and improved verification (avg 4.9% per-segment, total 2.8%). Rewrote compare_paths.py to correctly parse 47-byte frames (magic 0xDEADC0DE) with CRC-16 matching firmware, added --gps-guided mode, and added path-shape diagnostics. Diagnosed Madgwick magnetometer yaw locking as the root cause and applied a one-line firmware change switching filter to Mahony; added Phase 15 notes, updated milestones, status table, dates, and TODOs to requ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
2026-08-10 Clarify GPS as auxiliary extension (v2.3.0)
    Update Progress.md and Report.md to explicitly state that GPS is an optional auxiliary extension for outdoor MPU9250/filter calibration testing only — not part of the core indoor PDR system.
    Key clarifications:
    - GPS serves exclusively as external ground-truth reference for accuracy validation
    - WiFi Soft-AP phone pairing and NEO-6M module integration are optional add-ons
    - Core system is IMU-only (MPU9250) with offline Mahony-based PDR
    - Phase titles updated to emphasize extension status (e.g., 'Phase 11: WiFi GPS Anchoring for Outdoor Calibration')
    - Version bumped to 2.3.0, date updated to 2026-08-10
    This reflects architectural clarity that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
2026-08-10 Clarify core PDR architecture, update specs and file refs
    - Emphasized that GPS is an optional extension for outdoor calibration, not core navigation
    - Updated hardware specs: ESP32-S3 N16R8 (not N16R3), 47-byte LogFrame (not 48), PSRAM-backed queue
    - Added PDR pipeline accomplishments with validated 4.9% avg error
    - Reorganized hardware table to separate core components from optional GPS modules
    - Updated development status and phases; corrected Report/ file paths
    - Noted SD write speed (797 KB/s) and CRC integrity features in features list
